EfficiencyJunky/LEDLightSticks/README.md

# LEDLightSticks
A standalone light fixture that you can also wear
