EfficiencyJunky/LEDLightSticks/ENCLOSURE/3D_MODELS/V1p2/V1p2--STEP2--BottomMain.3mf

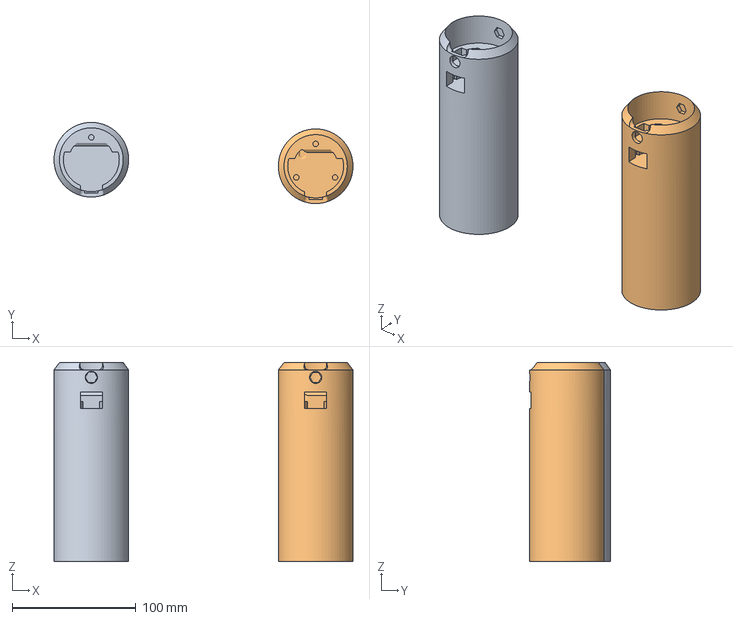
[picture p1: CAD file, 2021-01-06]
ENCLOSURE/3D_MODELS/V1p2/V1p2--STEP2--BottomMain.3mf
241.9 x 65.7 x 161.0 mm
V1--BOTTOM--sheeth_main--no_supports.stl
V1p2--BOTTOM--sheeth_main.stl
