EfficiencyJunky/LEDLightSticks/ENCLOSURE/3D_MODELS/V2p2/Lights_10_32/V1p2--STEP2--BottomMain_Updated_FAST.3mf

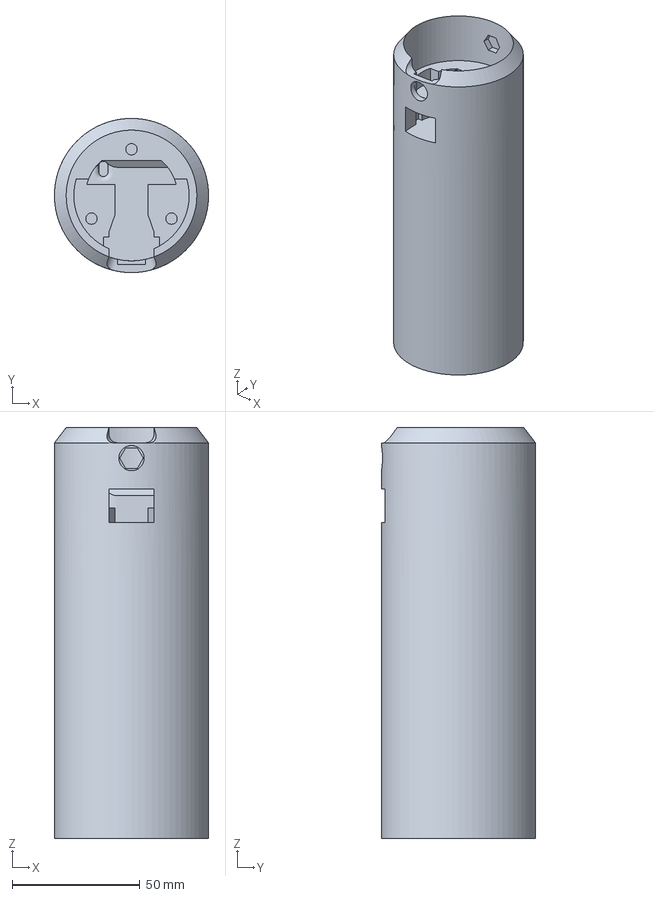
[picture p2: CAD file, 2021-01-07]
ENCLOSURE/3D_MODELS/V2p2/Lights_10_32/V1p2--STEP2--BottomMain_Updated_FAST.3mf
60.4 x 60.4 x 161.0 mm
