EfficiencyJunky/LEDLightSticks/ENCLOSURE/3D_MODELS/V2p2/Lights_M4/STEP4-TopCover/V2p2--M4--TopCover_COMPLETE_133.stl

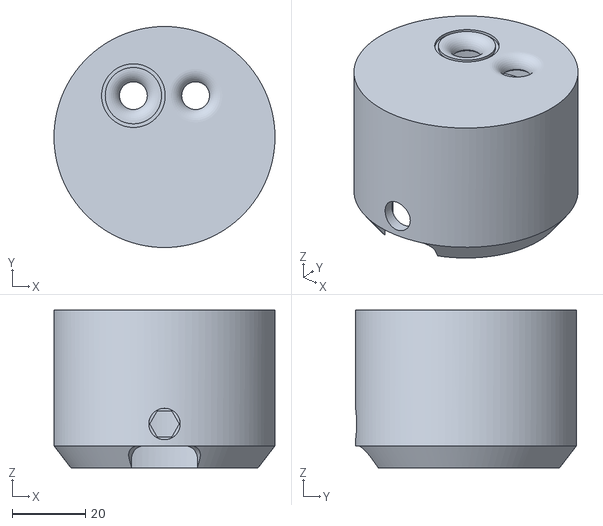
[picture p3: CAD file, 2024-03-03]
ENCLOSURE/3D_MODELS/V2p2/Lights_M4/STEP4-TopCover/V2p2--M4--TopCover_COMPLETE_133.stl
60.4 x 60.4 x 43.1
