EfficiencyJunky/LEDLightSticks/ENCLOSURE/3D_MODELS/V2p2/Lights_M4/STEP5-EntireThing/V2p2_127--M4--AllMainComponents.3mf

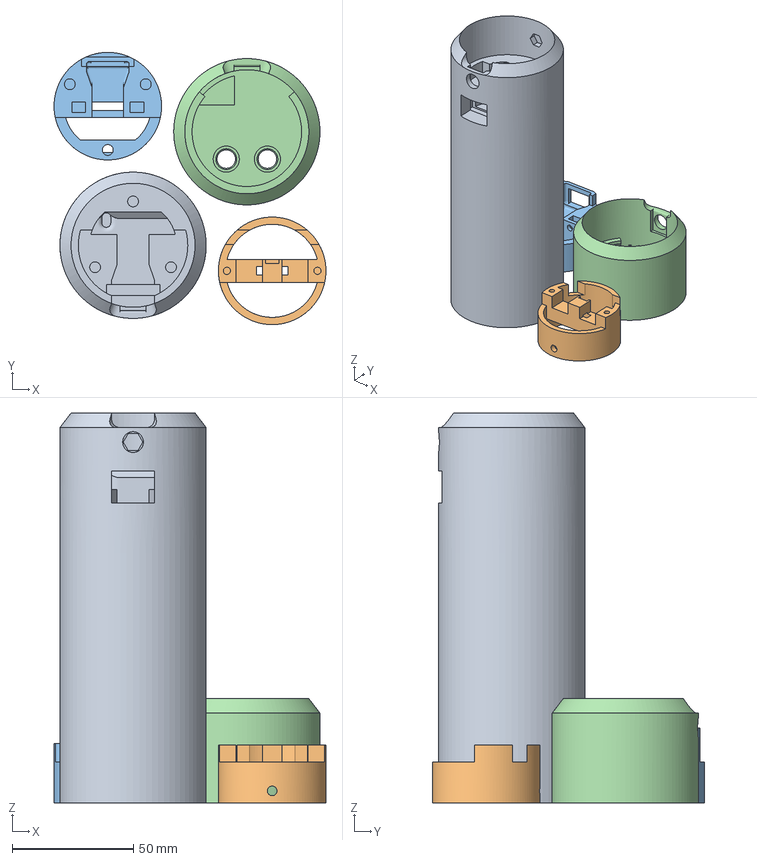
[picture p4: CAD file, 2021-03-30]
ENCLOSURE/3D_MODELS/V2p2/Lights_M4/STEP5-EntireThing/V2p2_127--M4--AllMainComponents.3mf
112.3 x 112.4 x 161.0 mm
V2p2--M4--handle_127.stl
V2p2--M4--Insert_top_123.stl
V2p2--M4--Insert_bottom_123
V2p2--M4--TopCover_COMPLETE_126.stl
