EfficiencyJunky/LEDLightSticks/ENCLOSURE/3D_MODELS/V2p2/Lights_M4/STEP4-TopCover/V2p2_133--M4--TopCover_COMPLETE_FAST_PETG.3mf

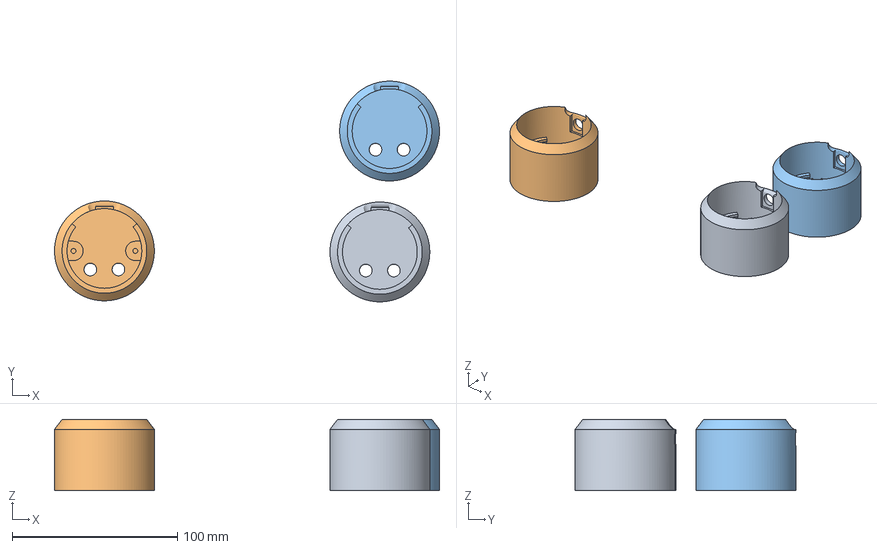
[picture p6: CAD file, 2024-03-03]
ENCLOSURE/3D_MODELS/V2p2/Lights_M4/STEP4-TopCover/V2p2_133--M4--TopCover_COMPLETE_FAST_PETG.3mf
232.9 x 133.5 x 43.1 mm
V2p2--M4--top_cover_125.stl
V2p2--M4--TopCover_COMPLETE_126.stl x 2
