EfficiencyJunky/LEDLightSticks/ENCLOSURE/3D_MODELS/V2p2/Lights_M4/STEP4-TopCover/V2p2_126--M4--TopCover_COMPLETE_FAST.3mf

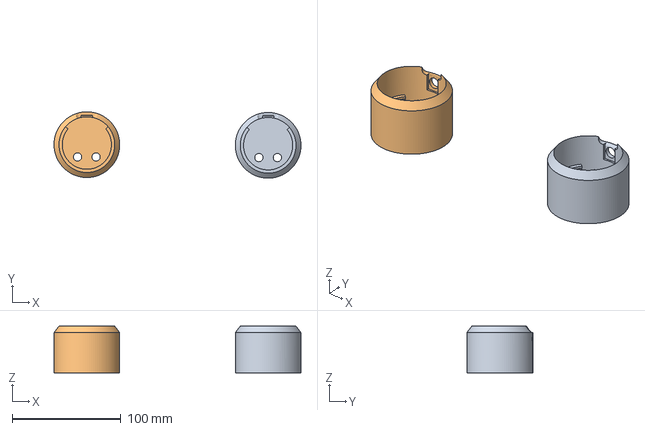
[picture p7: CAD file, 2021-03-30]
ENCLOSURE/3D_MODELS/V2p2/Lights_M4/STEP4-TopCover/V2p2_126--M4--TopCover_COMPLETE_FAST.3mf
227.0 x 61.0 x 43.1 mm
V2p2--M4--top_cover_125.stl
V2p2--M4--TopCover_COMPLETE_126.stl
