EfficiencyJunky/LEDLightSticks/ENCLOSURE/3D_MODELS/V1/V1_STLs/V1--BASE--main.stl

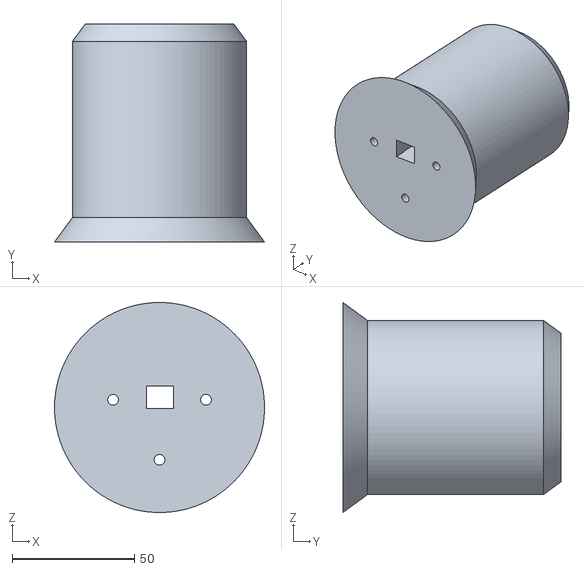
[picture p8: CAD file, 2020-12-22]
ENCLOSURE/3D_MODELS/V1/V1_STLs/V1--BASE--main.stl
85.8 x 89.1 x 85.9
