EfficiencyJunky/LEDLightSticks/ENCLOSURE/3D_MODELS/V1/V1_STLs/V1--TOP--sheeth_cap.stl

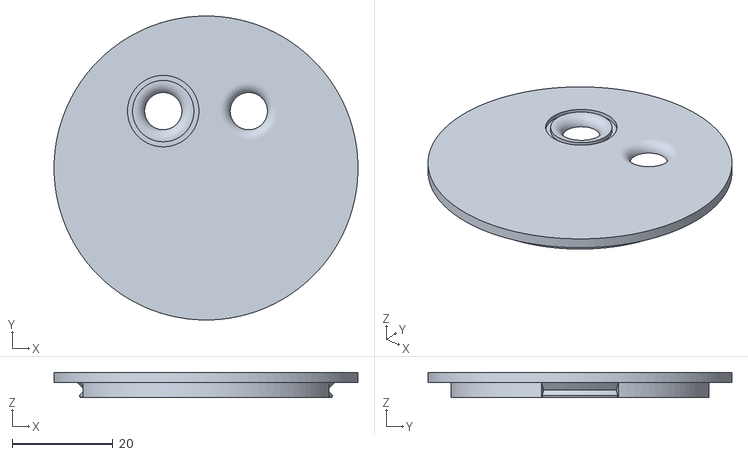
[picture p10: CAD file, 2020-12-22]
ENCLOSURE/3D_MODELS/V1/V1_STLs/V1--TOP--sheeth_cap.stl
60.4 x 60.4 x 5.00
