EfficiencyJunky/LEDLightSticks/ENCLOSURE/3D_MODELS/V2p2/Base/STEP1-PowerShimStorage/V2p2--power_shim_storage_006.stl

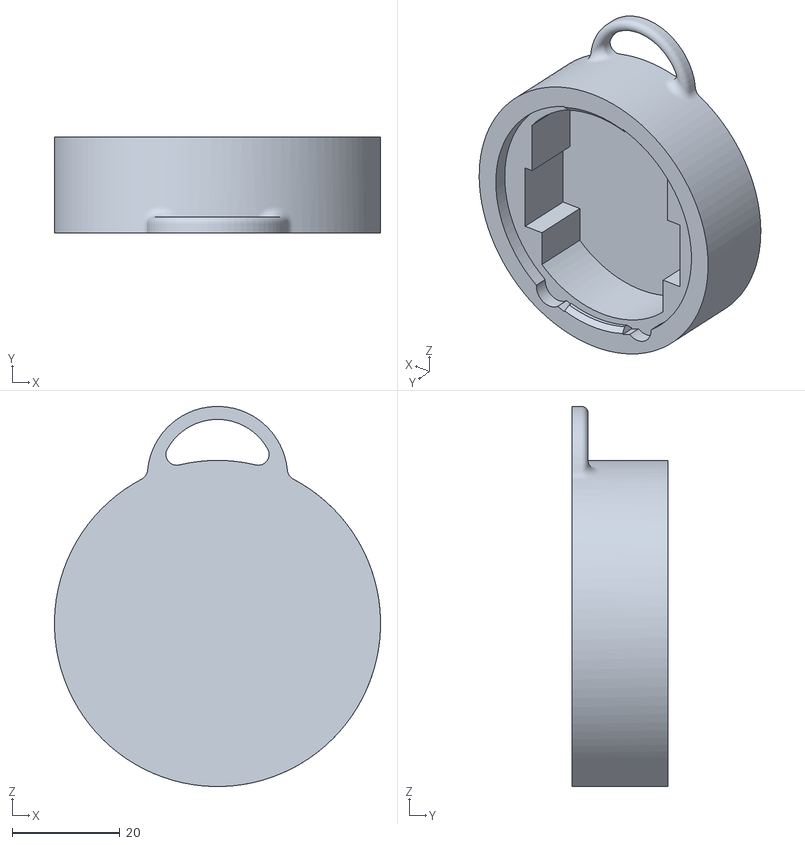
[picture p11: CAD file, 2021-02-16]
ENCLOSURE/3D_MODELS/V2p2/Base/STEP1-PowerShimStorage/V2p2--power_shim_storage_006.stl
60.4 x 17.8 x 70.4
