EfficiencyJunky/LEDLightSticks/ENCLOSURE/3D_MODELS/V2p2/Base/STEP4-PCBCover/V2p2_047--pcb_cover.3mf

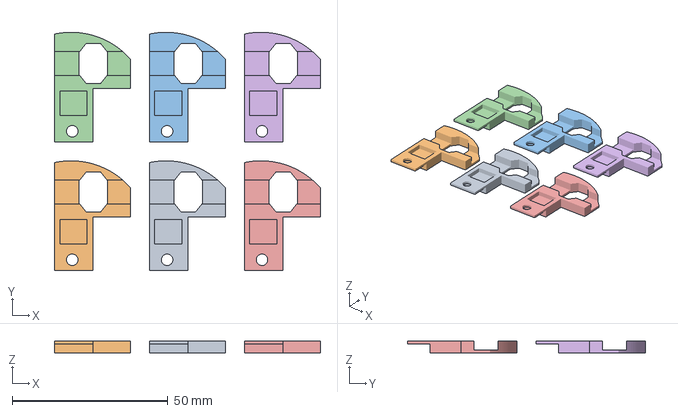
[picture p12: CAD file, 2021-03-30]
ENCLOSURE/3D_MODELS/V2p2/Base/STEP4-PCBCover/V2p2_047--pcb_cover.3mf
85.5 x 76.6 x 4.00 mm
V2p2--pcb_cover_047.stl x 6
