EfficiencyJunky/LEDLightSticks/ENCLOSURE/3D_MODELS/V2p2/Lights_M4/_OTHER_3D_FILES/STEP_BottomCoverCap_for_jake.step

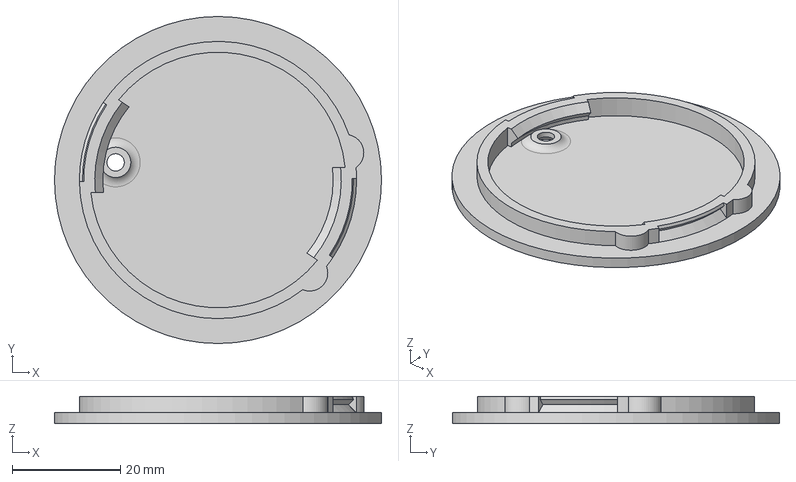
[picture p13: CAD file, 2024-03-03]
ENCLOSURE/3D_MODELS/V2p2/Lights_M4/_OTHER_3D_FILES/STEP_BottomCoverCap_for_jake.step
60.4 x 60.4 x 5.00 mm
