EfficiencyJunky/LEDLightSticks/ENCLOSURE/3D_MODELS/V2p2/Lights_M4/STEP0-Jig/V2p2--Jig_123.stl

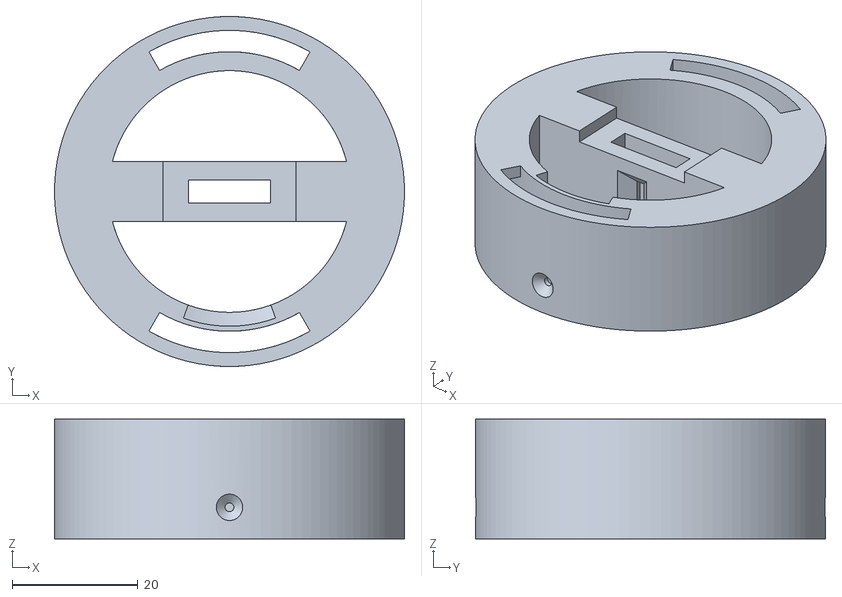
[picture p14: CAD file, 2021-02-16]
ENCLOSURE/3D_MODELS/V2p2/Lights_M4/STEP0-Jig/V2p2--Jig_123.stl
55.6 x 55.6 x 19.0
