EfficiencyJunky/LEDLightSticks/ENCLOSURE/3D_MODELS/V2p2/Lights_M4/STEP1-Inserts/V2p2--M4--Insert_bottom_133.stl

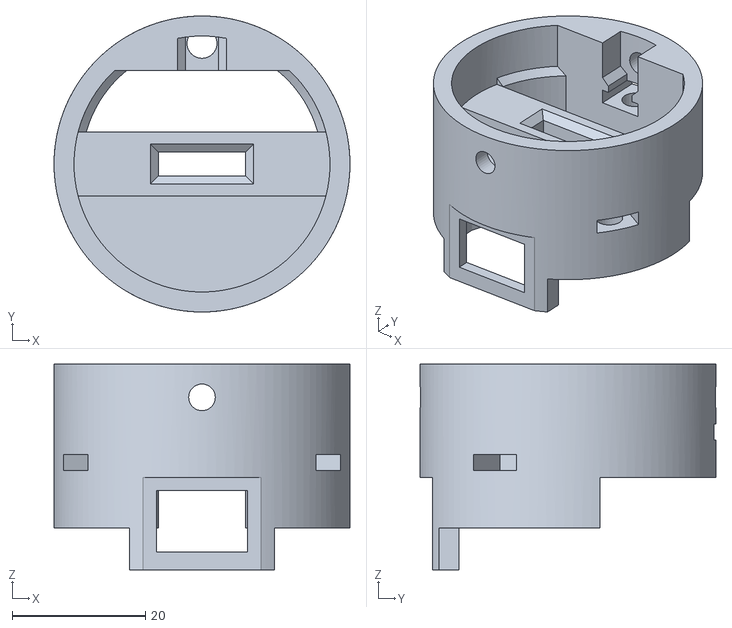
[picture p15: CAD file, 2024-03-03]
ENCLOSURE/3D_MODELS/V2p2/Lights_M4/STEP1-Inserts/V2p2--M4--Insert_bottom_133.stl
44.4 x 44.4 x 30.9
