EfficiencyJunky/LEDLightSticks/ENCLOSURE/3D_MODELS/V2p2/Lights_M4/STEP2-Handle/V2p2_127--M4--Handle_FAST.3mf

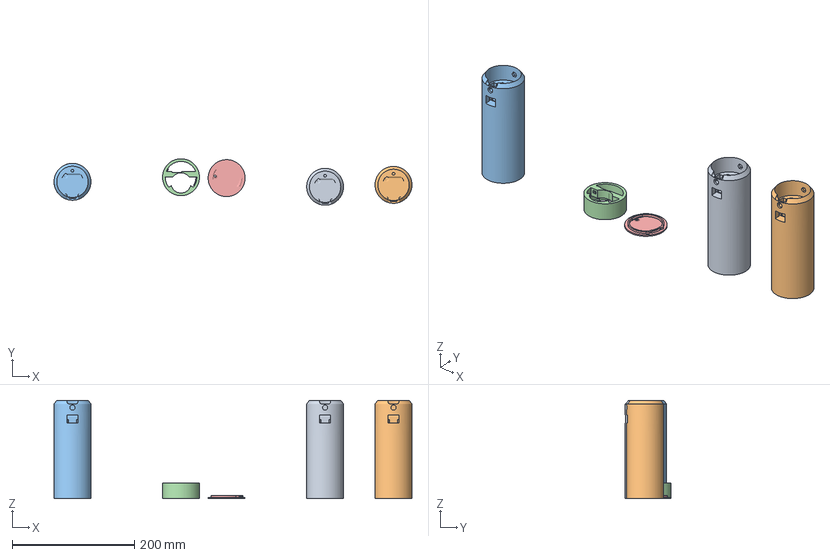
[picture p16: CAD file, 2024-03-03]
ENCLOSURE/3D_MODELS/V2p2/Lights_M4/STEP2-Handle/V2p2_127--M4--Handle_FAST.3mf
585.4 x 76.0 x 161.0 mm
V2p2--M4--handle_123.stl
V2p2--M4--handle_127.stl
V2p2--M4--handle_133.stl
V2p2--M4--handle_133_partial.stl
V2p2--bottom_cap_133.stl
