EfficiencyJunky/LEDLightSticks/ENCLOSURE/3D_MODELS/V1/V1--TOP.3mf

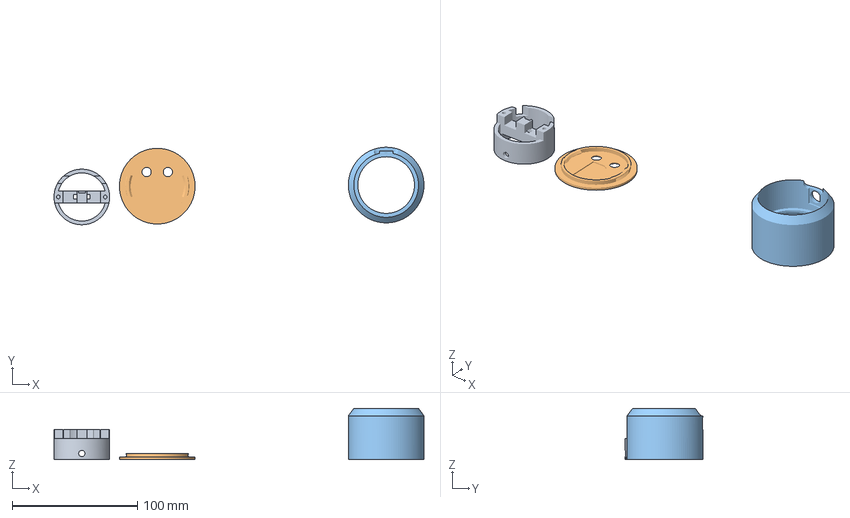
[picture p19: CAD file, 2020-12-22]
ENCLOSURE/3D_MODELS/V1/V1--TOP.3mf
295.4 x 61.9 x 41.1 mm
V1--TOP--foundation_insert.stl
V1--TOP--sheeth_cap.stl
V1--TOP--sheeth_main.stl
