EfficiencyJunky/LEDLightSticks/ENCLOSURE/3D_MODELS/V1/V1_STLs/V1--BOTTOM--battery_securing_clip.stl

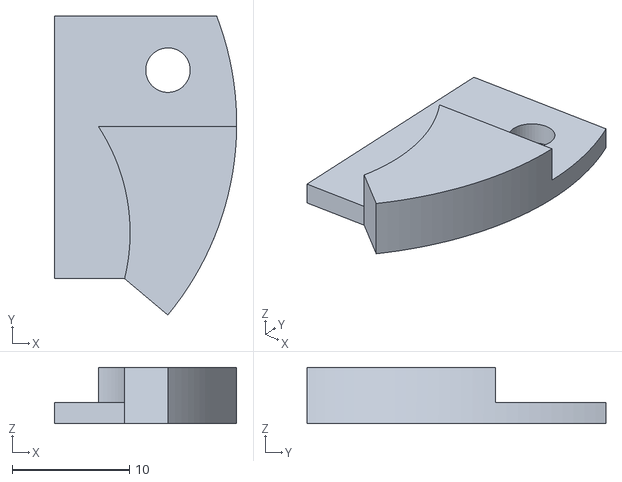
[picture p20: CAD file, 2020-12-22]
ENCLOSURE/3D_MODELS/V1/V1_STLs/V1--BOTTOM--battery_securing_clip.stl
15.6 x 25.5 x 4.80
