EfficiencyJunky/LEDLightSticks/ENCLOSURE/3D_MODELS/V2p2/Base/STEP4-PCBCover/V2p2--pcb_cover_047.stl

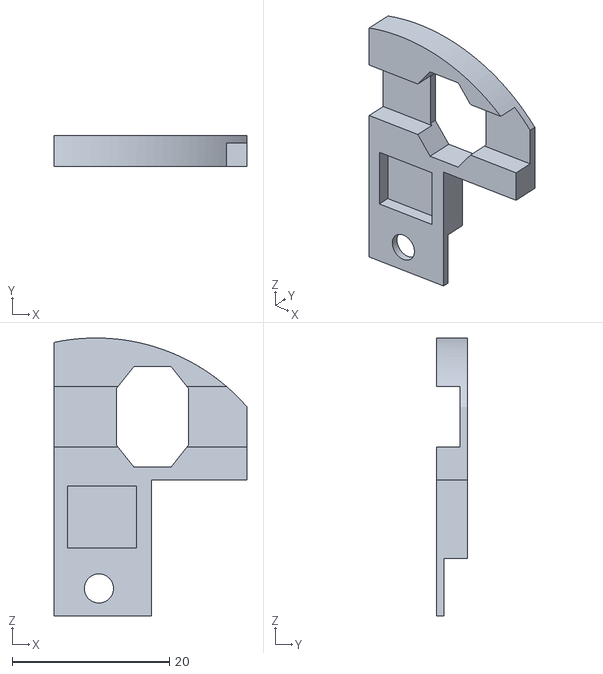
[picture p21: CAD file, 2021-02-16]
ENCLOSURE/3D_MODELS/V2p2/Base/STEP4-PCBCover/V2p2--pcb_cover_047.stl
24.5 x 4.00 x 35.3
