EfficiencyJunky/LEDLightSticks/ENCLOSURE/3D_MODELS/V2p2/Lights_M4/STEP1-Inserts/V2p2--M4--Inserts--133.3mf

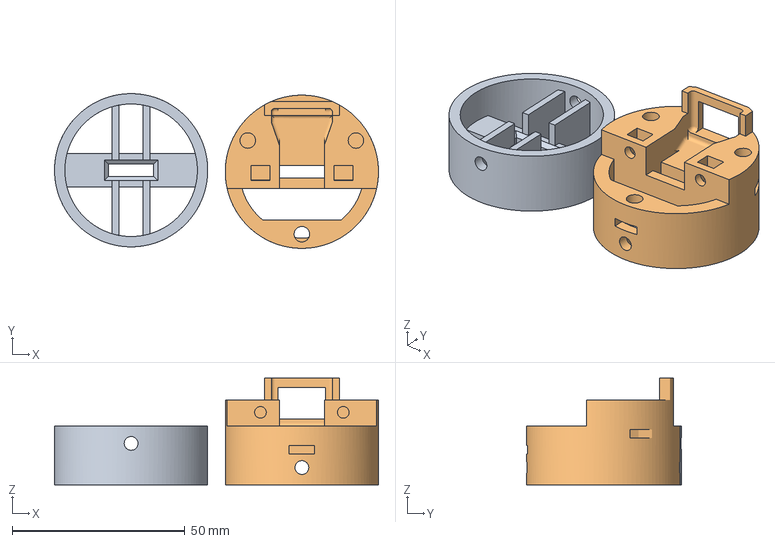
[picture p22: CAD file, 2024-03-03]
ENCLOSURE/3D_MODELS/V2p2/Lights_M4/STEP1-Inserts/V2p2--M4--Inserts--133.3mf
93.9 x 44.8 x 30.9 mm
V2p2--M4--Insert_top_123.stl
V2p2--M4--Insert_bottom_123
