EfficiencyJunky/LEDLightSticks/ENCLOSURE/3D_MODELS/V2p2/Lights_M4/STEP2-Handle/V2p2_135--M4--Handle_20um_layer_height_PETG.3mf

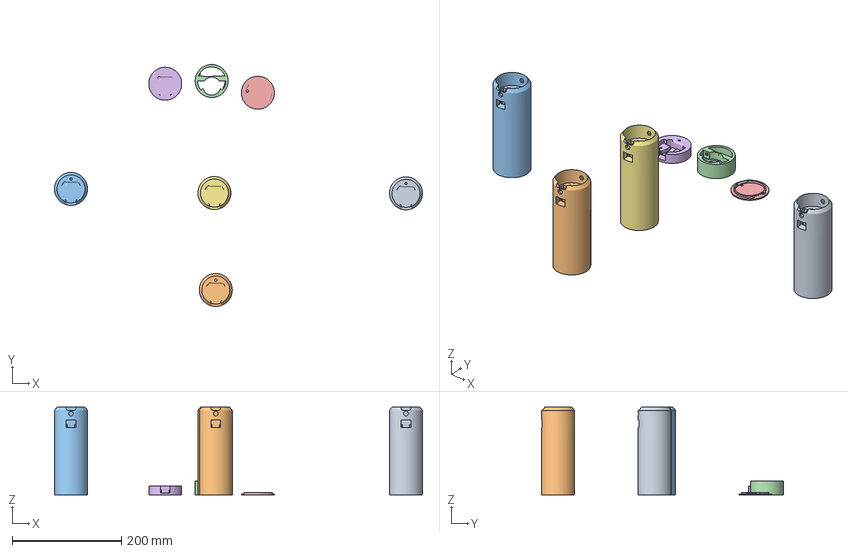
[picture p23: CAD file, 2024-03-03]
ENCLOSURE/3D_MODELS/V2p2/Lights_M4/STEP2-Handle/V2p2_135--M4--Handle_20um_layer_height_PETG.3mf
673.5 x 442.9 x 161.0 mm
V2p2--M4--handle_123.stl
V2p2--M4--handle_127.stl
V2p2--M4--handle_133.stl
V2p2--M4--handle_133_partial.stl
V2p2--bottom_cap_133.stl
V2p2--M4--handle_135_screw_fitting_area.stl
V2p2--M4--handle_135.stl
