EfficiencyJunky/LEDLightSticks/ENCLOSURE/3D_MODELS/V2p2/Lights_M4/STEP3-SmallComponents/V2p2_123--5x_Small_Components.3mf

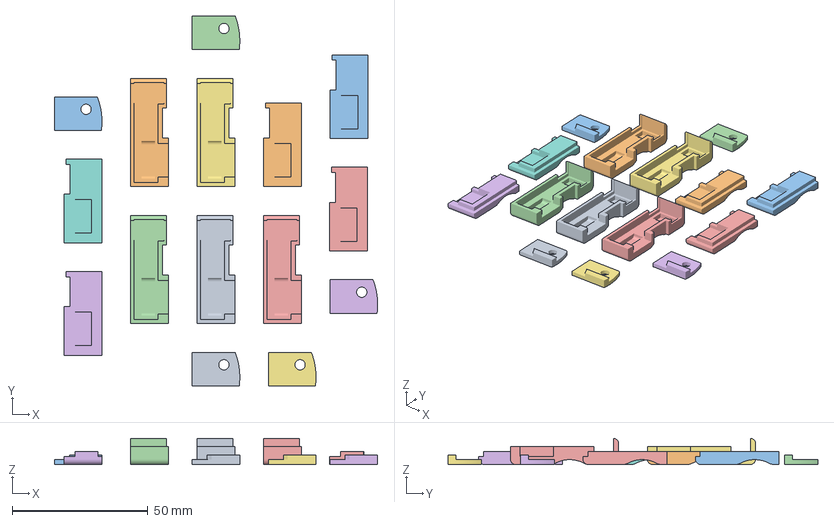
[picture p24: CAD file, 2024-03-03]
ENCLOSURE/3D_MODELS/V2p2/Lights_M4/STEP3-SmallComponents/V2p2_123--5x_Small_Components.3mf
119.3 x 136.5 x 9.60 mm
V2p2--powerShimCase_bottom_123.stl x 5
V2p2--powerShimCase_top_123.stl x 5
V2p2--battery_clip_123.stl x 5
