EfficiencyJunky/LEDLightSticks/ENCLOSURE/3D_MODELS/V1/V1--BOTTOM.3mf

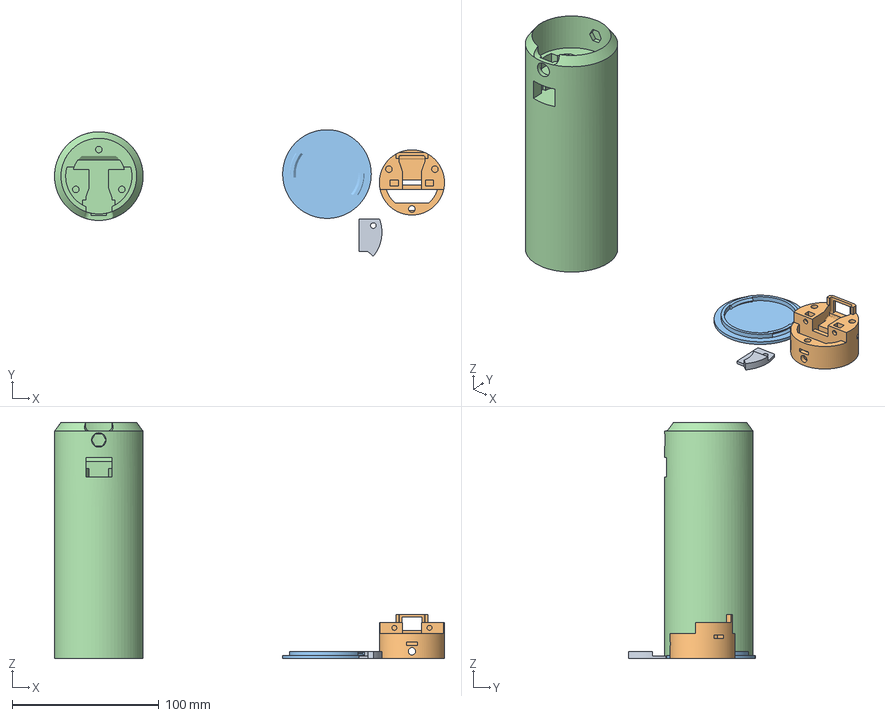
[picture p25: CAD file, 2020-12-22]
ENCLOSURE/3D_MODELS/V1/V1--BOTTOM.3mf
265.8 x 86.2 x 161.0 mm
V1--BOTTOM--battery_securing_clip.stl
V1--BOTTOM--foundation_insert.stl
V1--BOTTOM--sheeth_cap.stl
V1--BOTTOM--sheeth_main--no_supports.stl
