EfficiencyJunky/LEDLightSticks/ENCLOSURE/3D_MODELS/V2p2/Lights_M4/STEP1-Inserts/V2p2--M4--Insert_top_133.stl

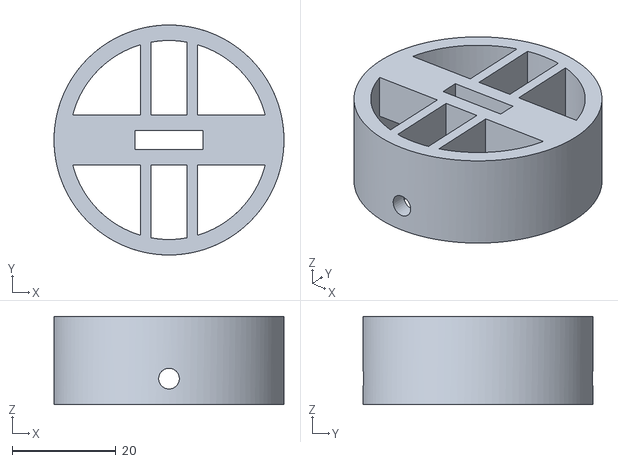
[picture p27: CAD file, 2024-03-03]
ENCLOSURE/3D_MODELS/V2p2/Lights_M4/STEP1-Inserts/V2p2--M4--Insert_top_133.stl
44.4 x 44.4 x 17.0
