EfficiencyJunky/LEDLightSticks/ENCLOSURE/3D_MODELS/V2p2/Lights_10_32/V1p2--STEP1--TopAndBottomInserts.3mf

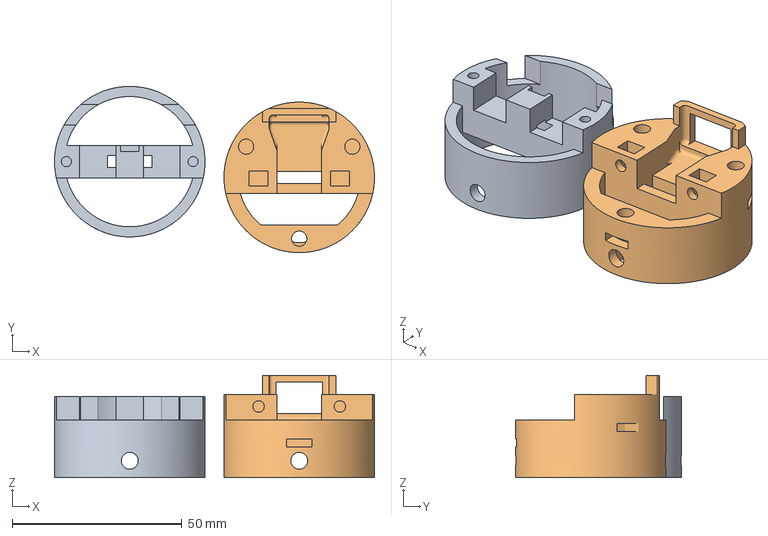
[picture p28: CAD file, 2021-01-05]
ENCLOSURE/3D_MODELS/V2p2/Lights_10_32/V1p2--STEP1--TopAndBottomInserts.3mf
94.4 x 49.0 x 30.2 mm
V1--TOP--foundation_insert.stl
V1--BOTTOM--foundation_insert.stl
