EfficiencyJunky/LEDLightSticks/ENCLOSURE/3D_MODELS/V2p2/Lights_M4/STEP1-Inserts/V2p2_133--M4--4X_Inserts_top_bottom_PLA.3mf

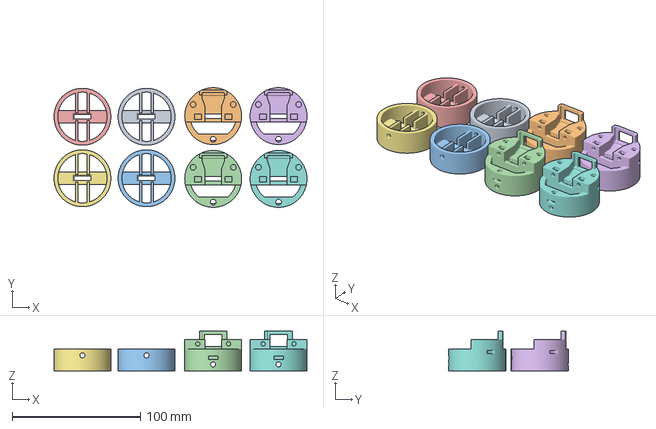
[picture p29: CAD file, 2024-03-03]
ENCLOSURE/3D_MODELS/V2p2/Lights_M4/STEP1-Inserts/V2p2_133--M4--4X_Inserts_top_bottom_PLA.3mf
197.4 x 93.4 x 30.9 mm
V2p2--M4--Insert_top_123.stl x 4
V2p2--M4--Insert_bottom_123 x 4
