EfficiencyJunky/LEDLightSticks/ENCLOSURE/3D_MODELS/V2p2/Lights_M4/STEP3-SmallComponents/V2p2_133--5x_Bottom_Cap_PLA.3mf

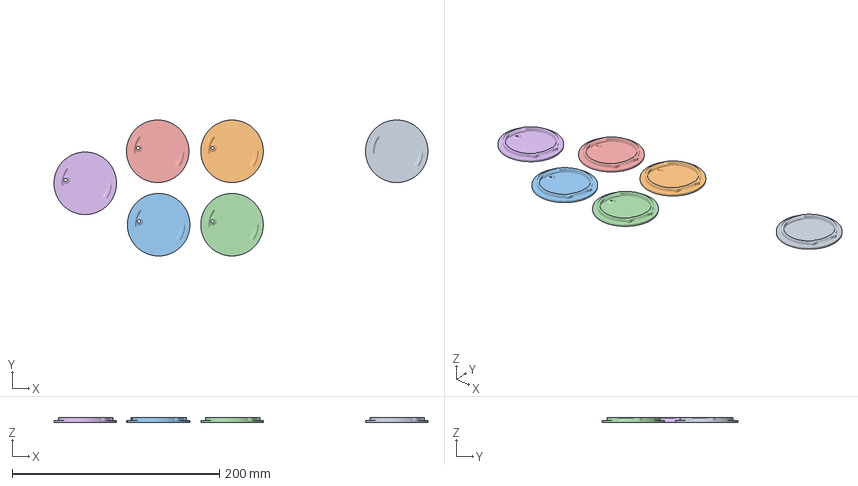
[picture p30: CAD file, 2024-03-03]
ENCLOSURE/3D_MODELS/V2p2/Lights_M4/STEP3-SmallComponents/V2p2_133--5x_Bottom_Cap_PLA.3mf
361.3 x 131.3 x 5.00 mm
V2p2--bottom_cap_125.stl
V2p2--bottom_cap_133.stl x 5
