EfficiencyJunky/LEDLightSticks/ENCLOSURE/3D_MODELS/V1/V1_STLs/V1--BOTTOM--foundation_insert.stl

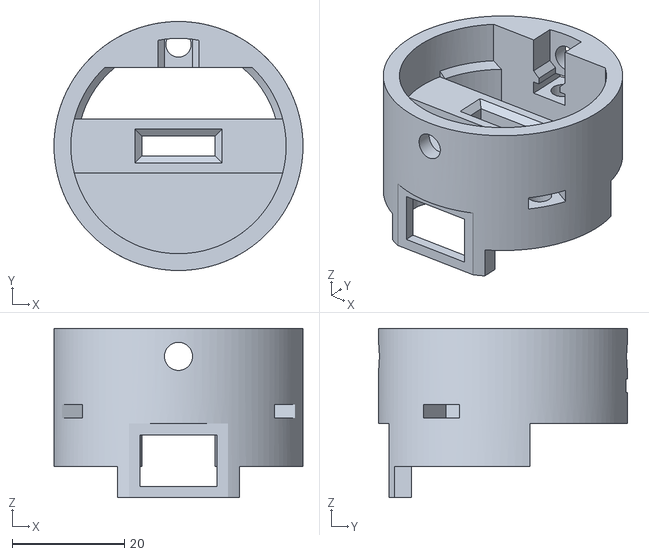
[picture p31: CAD file, 2020-12-22]
ENCLOSURE/3D_MODELS/V1/V1_STLs/V1--BOTTOM--foundation_insert.stl
44.4 x 44.4 x 30.2
