EfficiencyJunky/LEDLightSticks/ENCLOSURE/3D_MODELS/V2p2/Lights_10_32/V1p2--STEP4--TopSheethAndCap.3mf

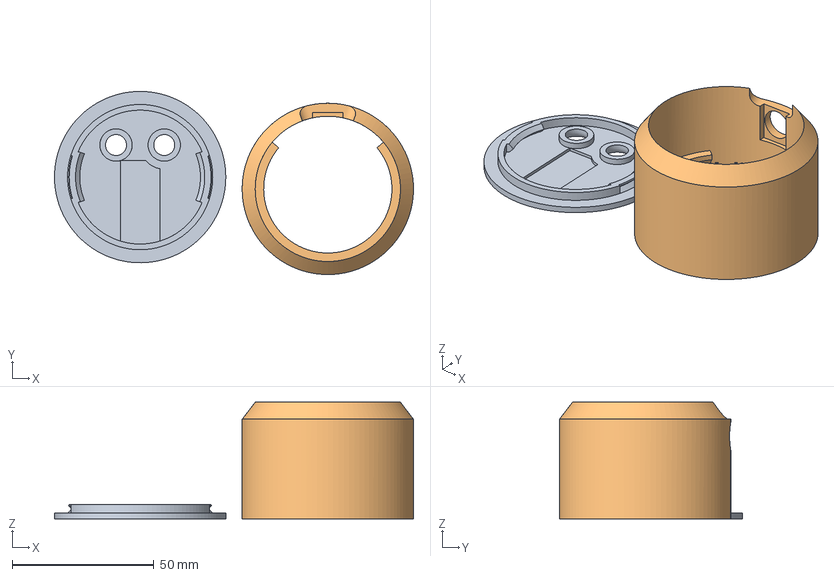
[picture p32: CAD file, 2021-01-05]
ENCLOSURE/3D_MODELS/V2p2/Lights_10_32/V1p2--STEP4--TopSheethAndCap.3mf
126.5 x 64.6 x 41.1 mm
V1p2--TOP--sheeth_cap.stl
V1p2--TOP--sheeth_main.stl
