EfficiencyJunky/LEDLightSticks/ENCLOSURE/3D_MODELS/V2p2/Lights_M4/STEP3-SmallComponents/V2p2_133--4x_Bottom_Cap_PETG.3mf

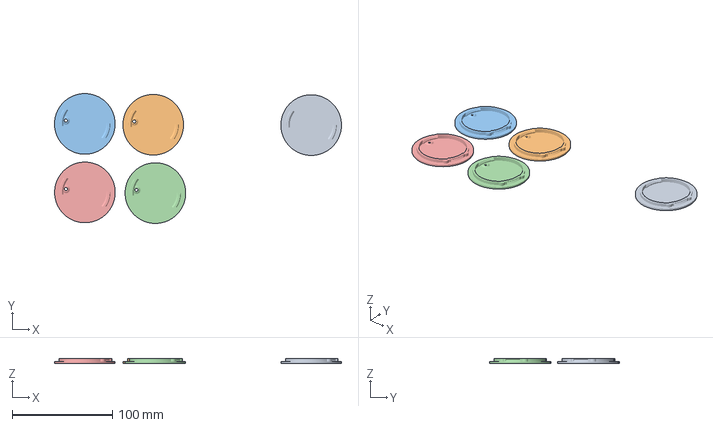
[picture p33: CAD file, 2024-03-03]
ENCLOSURE/3D_MODELS/V2p2/Lights_M4/STEP3-SmallComponents/V2p2_133--4x_Bottom_Cap_PETG.3mf
286.0 x 129.4 x 5.00 mm
V2p2--bottom_cap_125.stl
V2p2--bottom_cap_133.stl x 4
