EfficiencyJunky/LEDLightSticks/ENCLOSURE/3D_MODELS/V2p2/Lights_M4/STEP3-SmallComponents/V2p2_123--Small_Components.3mf

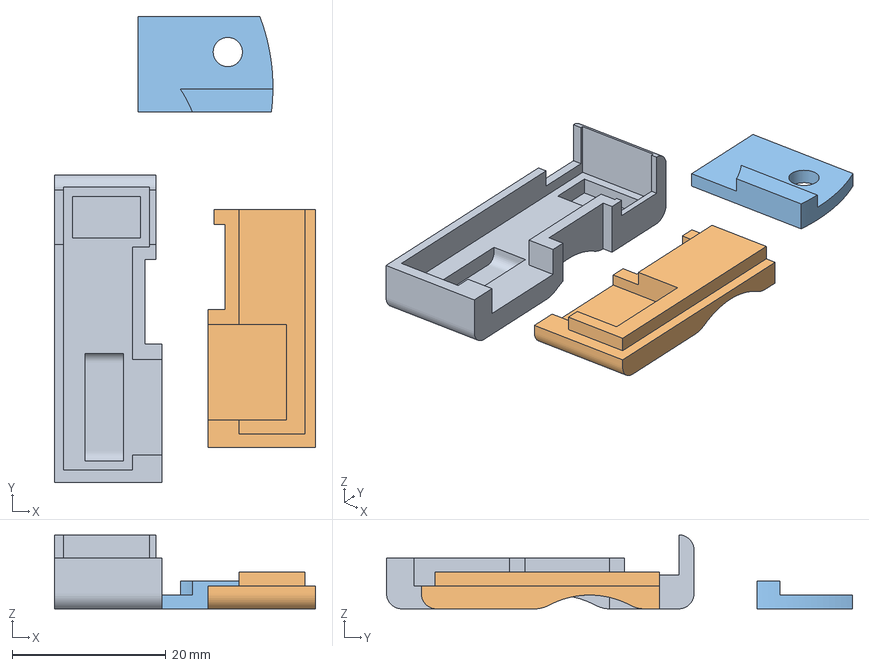
[picture p34: CAD file, 2024-03-03]
ENCLOSURE/3D_MODELS/V2p2/Lights_M4/STEP3-SmallComponents/V2p2_123--Small_Components.3mf
34.0 x 60.6 x 9.60 mm
V2p2--powerShimCase_bottom_123.stl
V2p2--powerShimCase_top_123.stl
V2p2--battery_clip_123.stl
