EfficiencyJunky/LEDLightSticks/ENCLOSURE/3D_MODELS/V2p2/Lights_M4/STEP3-SmallComponents/V2p2--powerShimCase_bottom_123.stl

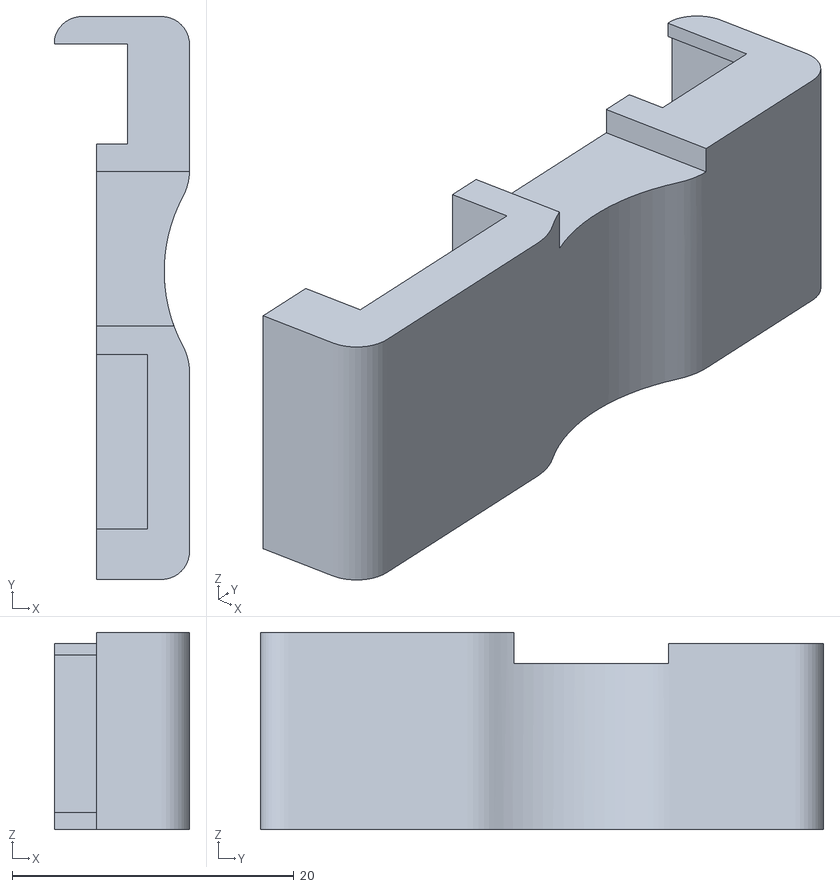
[picture p35: CAD file, 2021-02-16]
ENCLOSURE/3D_MODELS/V2p2/Lights_M4/STEP3-SmallComponents/V2p2--powerShimCase_bottom_123.stl
9.60 x 40.0 x 14.0
