EfficiencyJunky/LEDLightSticks/ENCLOSURE/3D_MODELS/V2p2/Lights_M4/STEP3-SmallComponents/V2p2--battery_clip_123.stl

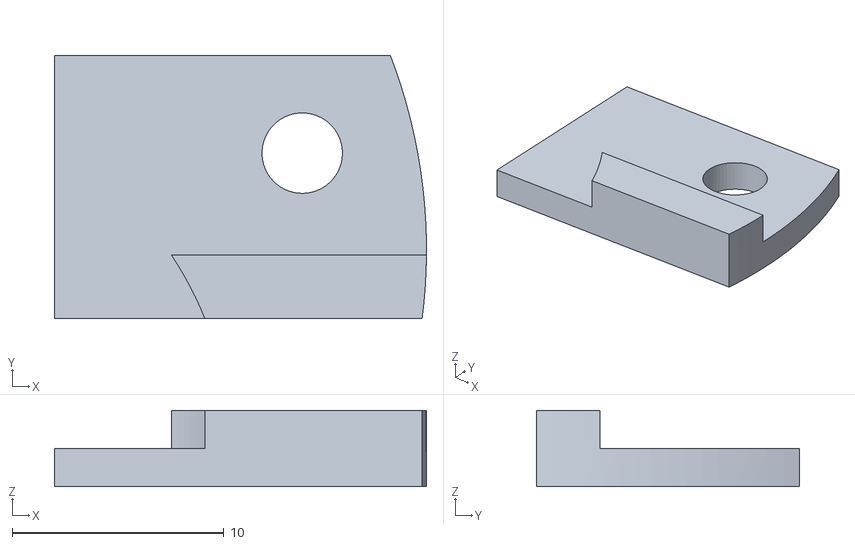
[picture p36: CAD file, 2021-02-16]
ENCLOSURE/3D_MODELS/V2p2/Lights_M4/STEP3-SmallComponents/V2p2--battery_clip_123.stl
17.6 x 12.4 x 3.60
