EfficiencyJunky/LEDLightSticks/ENCLOSURE/3D_MODELS/V2p2/Lights_M4/STEP3-SmallComponents/V2p2--powerShimCase_top_123.stl

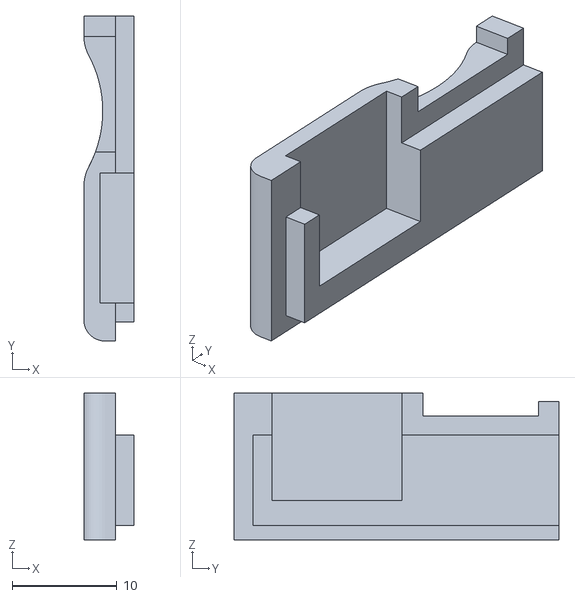
[picture p37: CAD file, 2021-02-16]
ENCLOSURE/3D_MODELS/V2p2/Lights_M4/STEP3-SmallComponents/V2p2--powerShimCase_top_123.stl
4.80 x 31.0 x 14.0
