EfficiencyJunky/LEDLightSticks/(list of files, cad)

Other CAD files:
ENCLOSURE/3D_MODELS/V2p2/Lights_10_32/V1p2--STEP2--BottomMain_Updated.3mf
ENCLOSURE/3D_MODELS/V2p2/Lights_M4/STEP4-TopCover/V2p2_133--M4--TopCover_COMPLETE_FAST.3mf
ENCLOSURE/3D_MODELS/V2p2/Lights_M4/STEP4-TopCover/V2p2--M4--TopCover_COMPLETE_126.stl
ENCLOSURE/3D_MODELS/V1/V1_STLs/V1--BOTTOM--sheeth_main--no_supports.stl
ENCLOSURE/3D_MODELS/V1/V1_STLs/V1--BOTTOM--sheeth_main--supports.stl
ENCLOSURE/3D_MODELS/V1/V1--BASE.3mf
ENCLOSURE/3D_MODELS/V2p2/Base/STEP3-BaseMain/V2p2_058--Base.3mf
ENCLOSURE/3D_MODELS/V2p2/Base/STEP1-PowerShimStorage/V2p2_006--power_shim_storage.3mf
ENCLOSURE/3D_MODELS/V2p2/Base/STEP3-BaseMain/V2p2_057--Base.3mf
ENCLOSURE/3D_MODELS/V2p2/Lights_M4/STEP0-Jig/V2p2_123--Jig.3mf
ENCLOSURE/3D_MODELS/V2p2/Lights_10_32/V1p2--JIGS.3mf
ENCLOSURE/3D_MODELS/V2p2/Lights_M4/STEP2-Handle/V2p2--M4--handle_135.stl
ENCLOSURE/3D_MODELS/V2p2/Lights_M4/STEP3-SmallComponents/V2p2_133--Bottom_Cap_PLA.3mf
ENCLOSURE/3D_MODELS/V1/V1_STLs/V1--BOTTOM--sheeth_cap.stl
ENCLOSURE/3D_MODELS/V2p2/Lights_M4/STEP2-Handle/V2p2_135--M4--Handle_FAST.3mf
ENCLOSURE/3D_MODELS/V2p2/Lights_M4/STEP1-Inserts/V2p2--M4--Insert_top_123.stl
ENCLOSURE/3D_MODELS/V2p2/Lights_M4/STEP2-Handle/V2p2_135--M4--Handle_FAST_PETG.3mf
ENCLOSURE/3D_MODELS/V2p2/Lights_M4/STEP1-Inserts/V2p2--M4--Insert_bottom_123.stl
ENCLOSURE/3D_MODELS/V2p2/Lights_M4/STEP2-Handle/V2p2--M4--handle_133.stl
ENCLOSURE/3D_MODELS/V2p2/Lights_M4/STEP3-SmallComponents/V2p2--bottom_cap_133.stl
ENCLOSURE/3D_MODELS/V2p2/Lights_M4/STEP4-TopCover/V2p2_123--M4--TopCover.3mf
ENCLOSURE/3D_MODELS/V2p2/Lights_M4/STEP1-Inserts/V2p2--M4--Inserts-123.3mf
ENCLOSURE/3D_MODELS/V2p2/Lights_M4/STEP2-Handle/V2p2--M4--handle_123.stl
ENCLOSURE/3D_MODELS/V2p2/Lights_M4/STEP2-Handle/V2p2--M4--handle_127.stl
ENCLOSURE/3D_MODELS/V2p2/Lights_M4/STEP2-Handle/V2p2_123--M4--Handle.3mf
ENCLOSURE/3D_MODELS/V2p2/Lights_M4/STEP3-SmallComponents/V2p2--bottom_cap_125.stl
ENCLOSURE/3D_MODELS/V2p2/Lights_M4/STEP3-SmallComponents/V2p2_125--Bottom_Cap.3mf
ENCLOSURE/3D_MODELS/V2p2/Base/STEP3-BaseMain/V2p2_058--Base.stl
