EfficiencyJunky/LEDLightSticks/BUILD/Base/README.md

# LED Light Sticks 2.0 - Acrylic Base Build

## Tools
**PlastiDrill Bit**
* **5/32"** for M4 Mounting Bolt Holes in Acrylic Base
* **1/4"** for starter hole in Acrylic base where power plug goes

**Regular Drill Bits**
* **1/2"** for final hole in Acrylic base where power plug goes

# Acrylic Base Preparation
## 	PARTS
1. 1x -- Acrylic Base
2. 1x -- 3D Printed LED Light Stick Holder
3. 1x -- PCB #5
   1. Molex Male Straight Header
   2. DC Barrel Connector - Vertical Board Mount
4. 1x -- 3D Printed cover for PCB
5. 3x -- 4M x 25mm Bolts
6. 3x -- 4M Hex lock nuts
7. 3x -- #6 x 1/4" Thread Cutting Screws
8.  5x -- Rubber feet
9.  1x -- USB to Barrel connector cable (6ft)
