EfficiencyJunky/LEDLightSticks/BUILD/LightSticks/TUTORIAL_IMAGES/STEP_01/02--Mark_hole_placements.jpeg

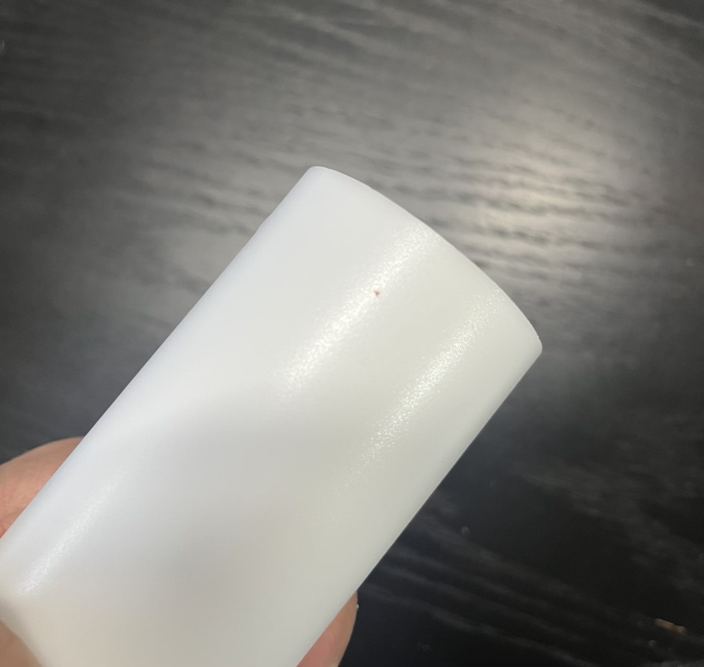
BUILD/LightSticks/TUTORIAL_IMAGES/STEP_01/02--Mark_hole_placements.jpeg
