EfficiencyJunky/LEDLightSticks/BUILD/LightSticks/TUTORIAL_IMAGES/STEP_01/03--Drill_hole.jpeg

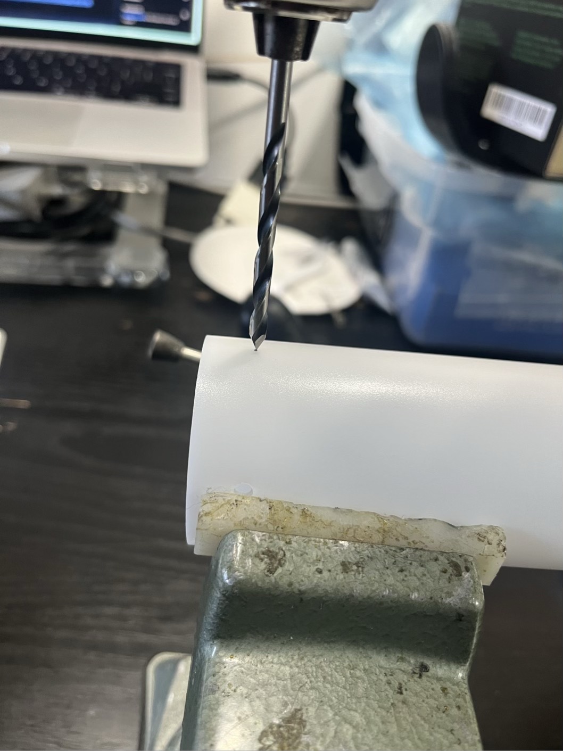
BUILD/LightSticks/TUTORIAL_IMAGES/STEP_01/03--Drill_hole.jpeg
