EfficiencyJunky/LEDLightSticks/BUILD/LightSticks/TUTORIAL_IMAGES/STEP_01/05--Mark_flat_bar.jpeg

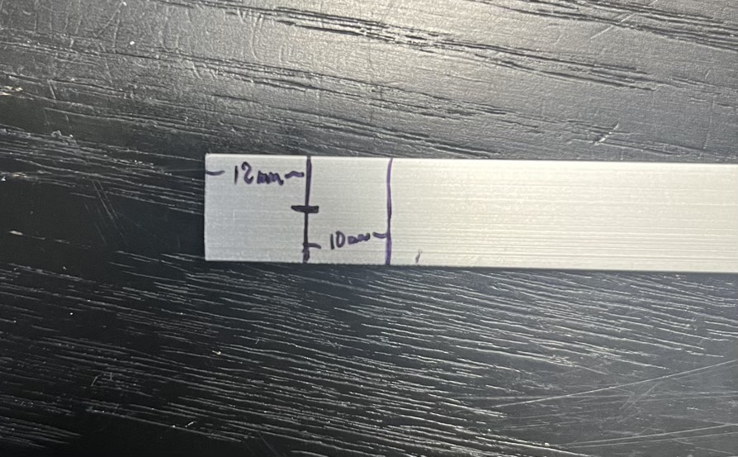
BUILD/LightSticks/TUTORIAL_IMAGES/STEP_01/05--Mark_flat_bar.jpeg
