EfficiencyJunky/LEDLightSticks/BUILD/LightSticks/TUTORIAL_IMAGES/STEP_01/06--Drill_flat_bar.jpeg

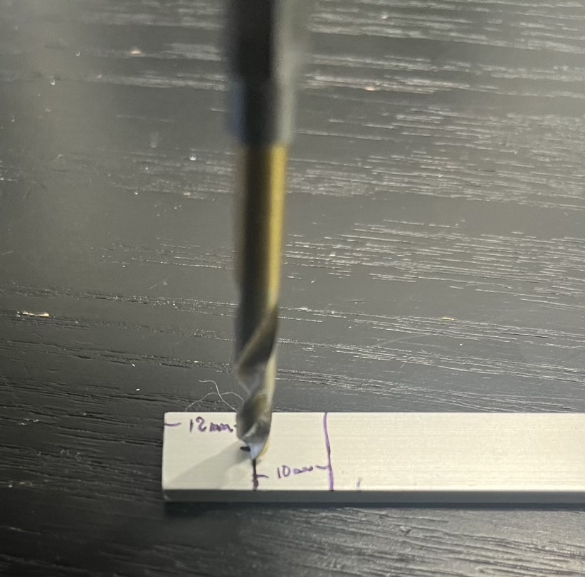
BUILD/LightSticks/TUTORIAL_IMAGES/STEP_01/06--Drill_flat_bar.jpeg
