EfficiencyJunky/LEDLightSticks/BUILD/LightSticks/TUTORIAL_IMAGES/STEP_01/08--fit_flat_bar_in_insert.jpeg

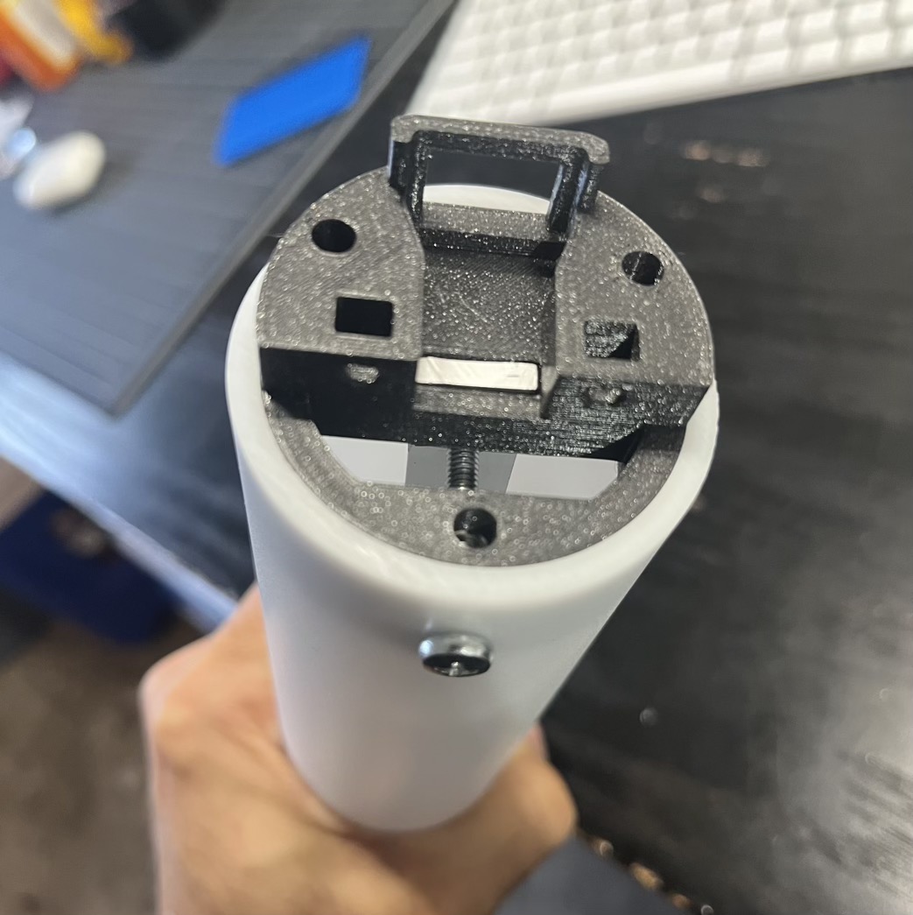
BUILD/LightSticks/TUTORIAL_IMAGES/STEP_01/08--fit_flat_bar_in_insert.jpeg
