EfficiencyJunky/LEDLightSticks/BUILD/LightSticks/TUTORIAL_IMAGES/STEP_01/09--fit_jig_on_other_end.jpeg

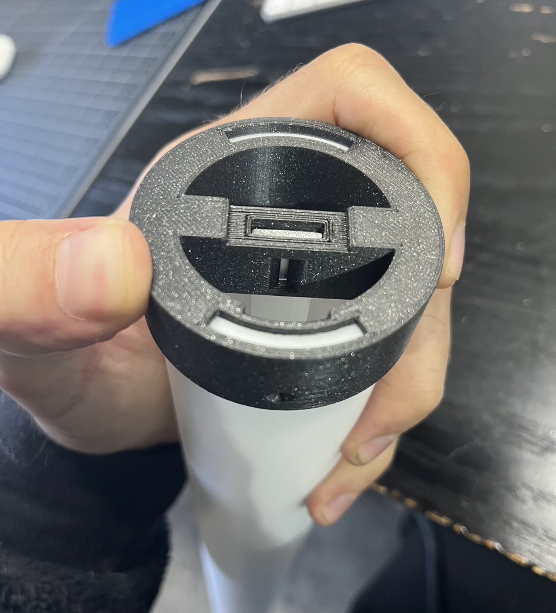
BUILD/LightSticks/TUTORIAL_IMAGES/STEP_01/09--fit_jig_on_other_end.jpeg
