EfficiencyJunky/LEDLightSticks/BUILD/LightSticks/TUTORIAL_IMAGES/STEP_01/11--Mark_actylic_tube_hole_placements.jpeg

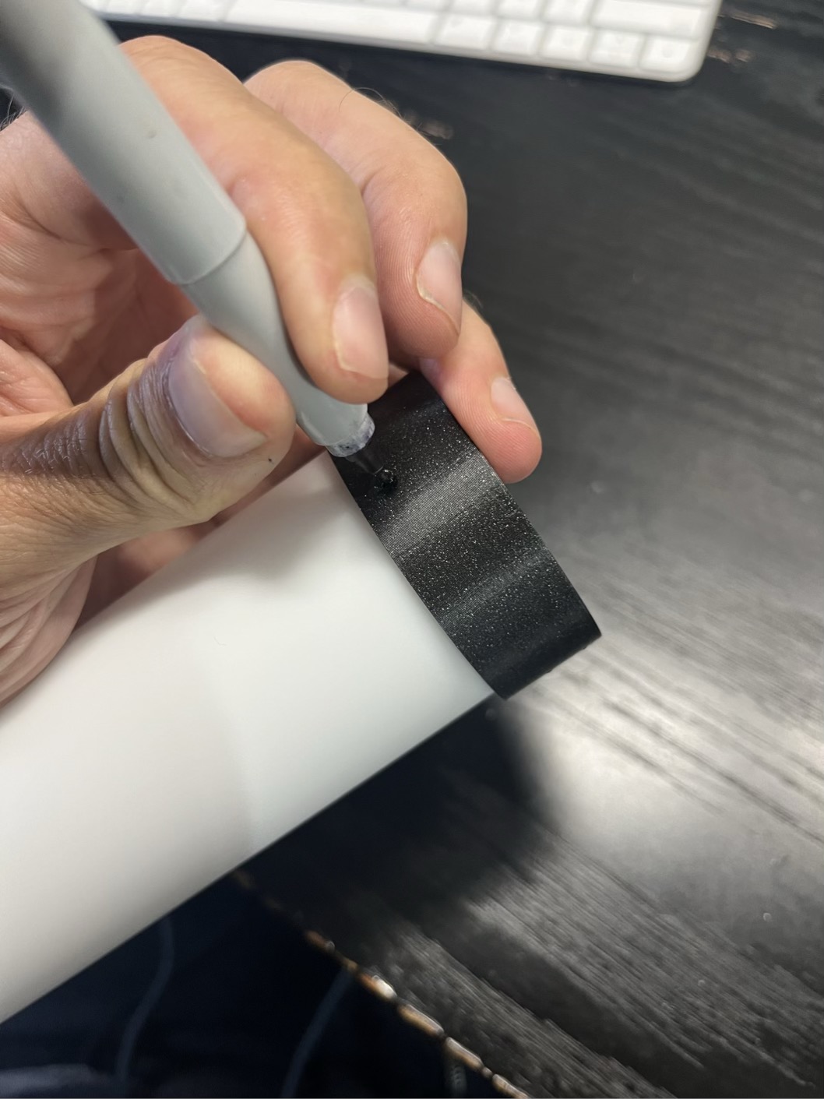
BUILD/LightSticks/TUTORIAL_IMAGES/STEP_01/11--Mark_actylic_tube_hole_placements.jpeg
