EfficiencyJunky/LEDLightSticks/BUILD/LightSticks/TUTORIAL_IMAGES/STEP_01/12--B_Mark_flat_bar_hole_placement.jpeg

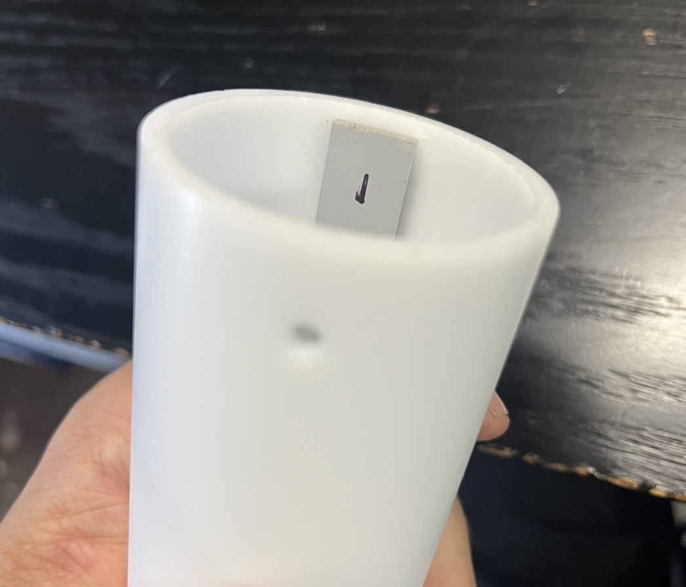
BUILD/LightSticks/TUTORIAL_IMAGES/STEP_01/12--B_Mark_flat_bar_hole_placement.jpeg
