EfficiencyJunky/LEDLightSticks/BUILD/LightSticks/TUTORIAL_IMAGES/STEP_01/14--Mark_flat_bar_10mm_line.jpeg

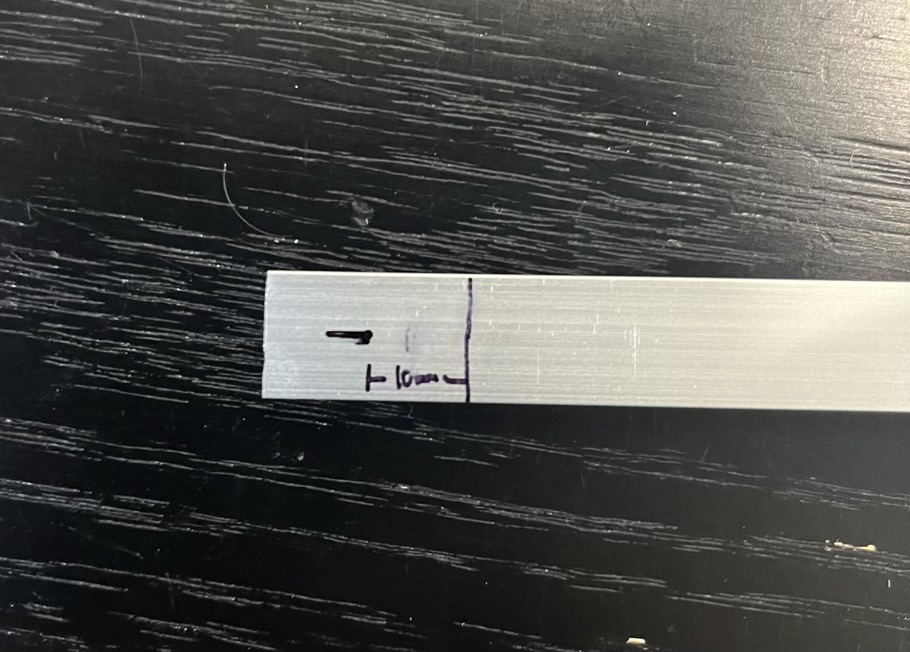
BUILD/LightSticks/TUTORIAL_IMAGES/STEP_01/14--Mark_flat_bar_10mm_line.jpeg
