EfficiencyJunky/LEDLightSticks/BUILD/LightSticks/TUTORIAL_IMAGES/STEP_01/16--Drill_flat_bar.jpeg

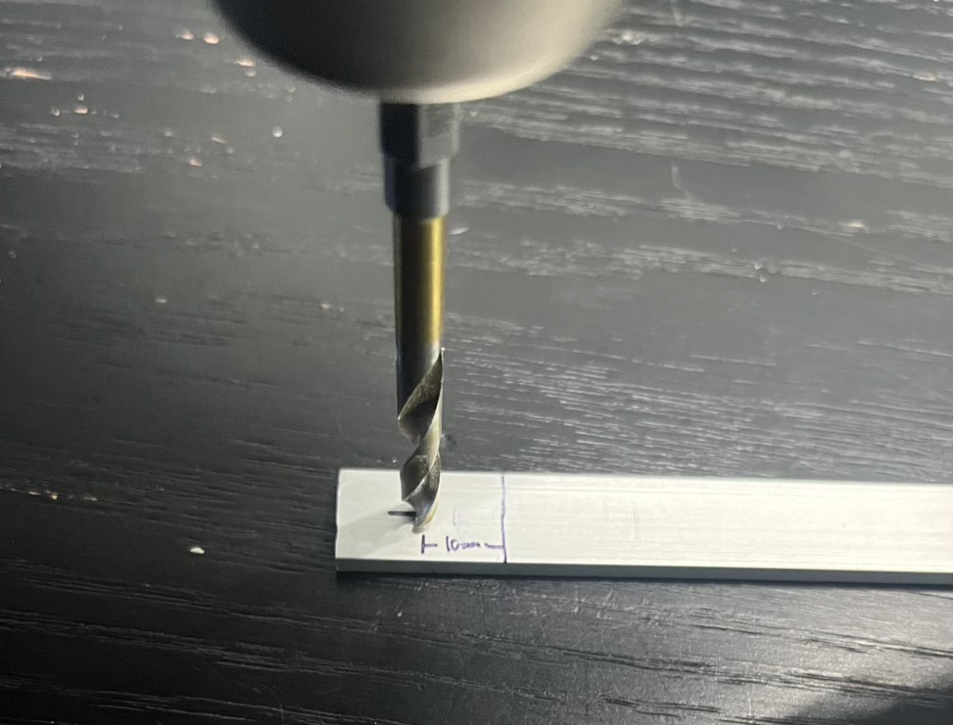
BUILD/LightSticks/TUTORIAL_IMAGES/STEP_01/16--Drill_flat_bar.jpeg
