EfficiencyJunky/LEDLightSticks/BUILD/LightSticks/TUTORIAL_IMAGES/STEP_02/01--B_JSTxhx3_cut.jpeg

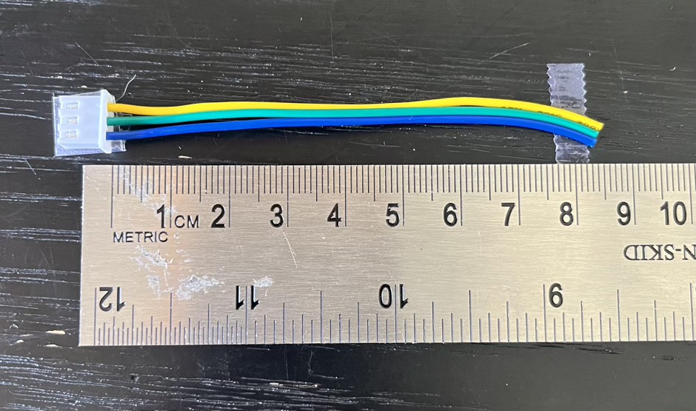
BUILD/LightSticks/TUTORIAL_IMAGES/STEP_02/01--B_JSTxhx3_cut.jpeg
