EfficiencyJunky/LEDLightSticks/BUILD/LightSticks/TUTORIAL_IMAGES/STEP_02/02--JSTxhx3_stripped_and_tinned.jpeg

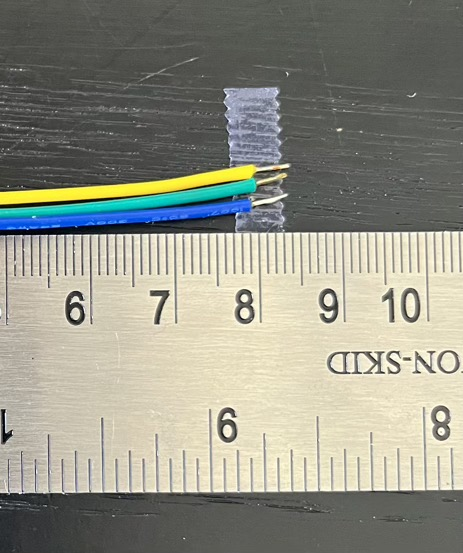
BUILD/LightSticks/TUTORIAL_IMAGES/STEP_02/02--JSTxhx3_stripped_and_tinned.jpeg
