EfficiencyJunky/LEDLightSticks/BUILD/LightSticks/TUTORIAL_IMAGES/STEP_02/04--LED_strip_tinned.jpeg

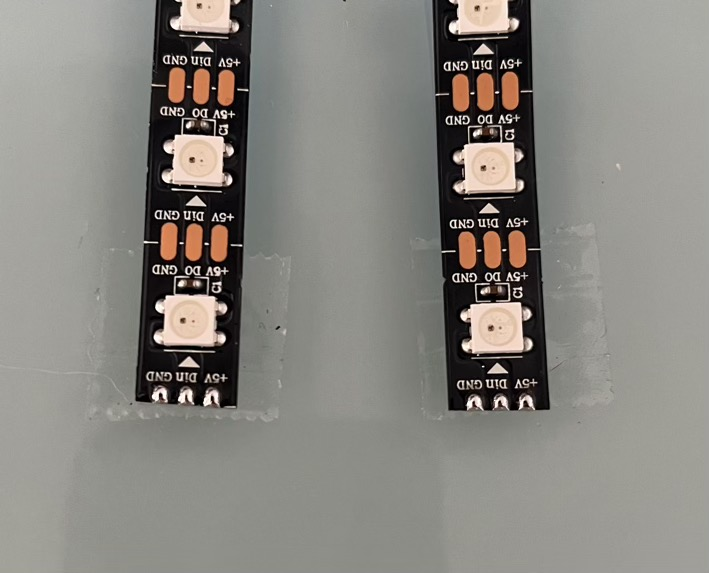
BUILD/LightSticks/TUTORIAL_IMAGES/STEP_02/04--LED_strip_tinned.jpeg
