EfficiencyJunky/LEDLightSticks/BUILD/LightSticks/TUTORIAL_IMAGES/STEP_02/05--HeatShrink_on_wires.jpeg

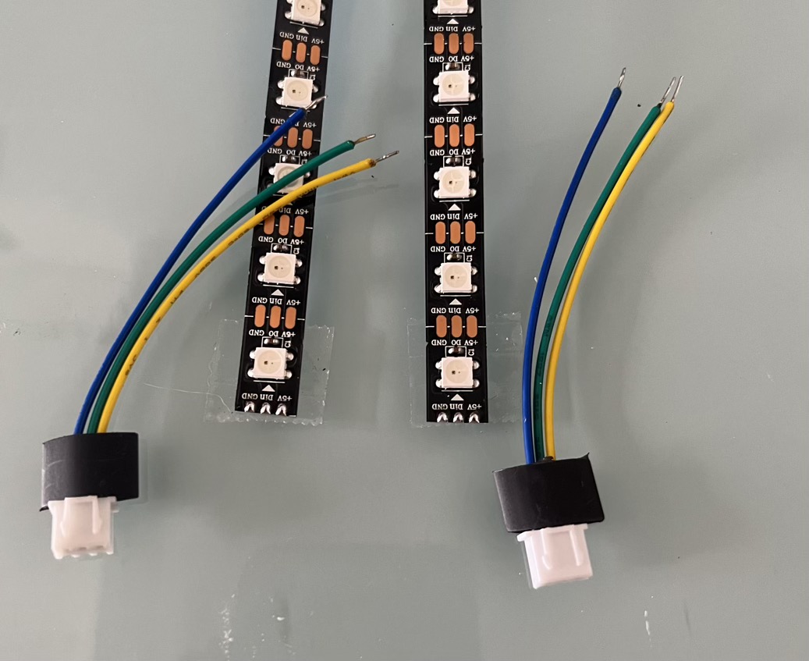
BUILD/LightSticks/TUTORIAL_IMAGES/STEP_02/05--HeatShrink_on_wires.jpeg
