EfficiencyJunky/LEDLightSticks/BUILD/LightSticks/TUTORIAL_IMAGES/STEP_02/06--A_JSTxhx3_solder.jpeg

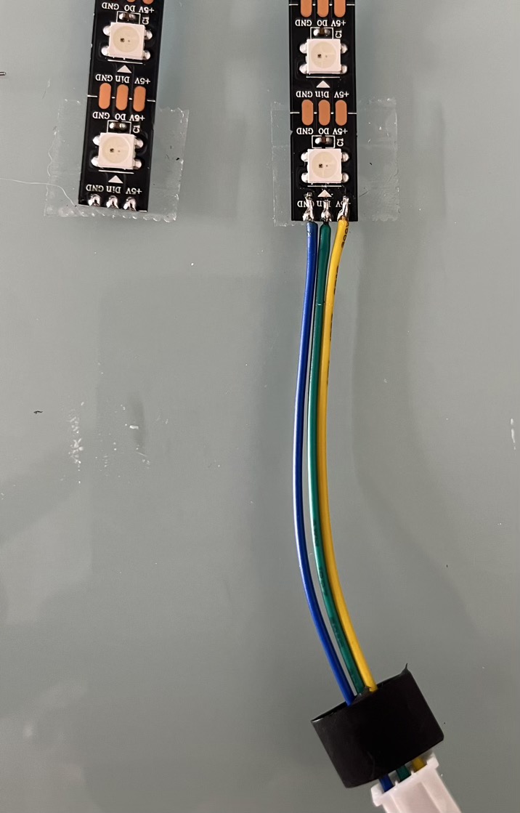
BUILD/LightSticks/TUTORIAL_IMAGES/STEP_02/06--A_JSTxhx3_solder.jpeg
