EfficiencyJunky/LEDLightSticks/BUILD/LightSticks/TUTORIAL_IMAGES/STEP_02/07--A_JSTxhx3_heatshrink.jpeg

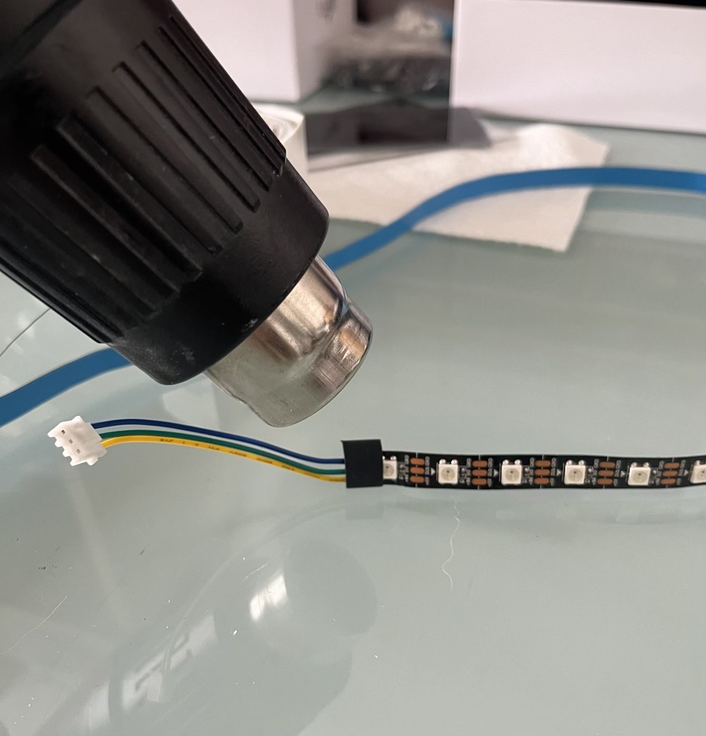
BUILD/LightSticks/TUTORIAL_IMAGES/STEP_02/07--A_JSTxhx3_heatshrink.jpeg
