EfficiencyJunky/LEDLightSticks/BUILD/LightSticks/TUTORIAL_IMAGES/STEP_02/08--B_JSTxhx2_cut.jpeg

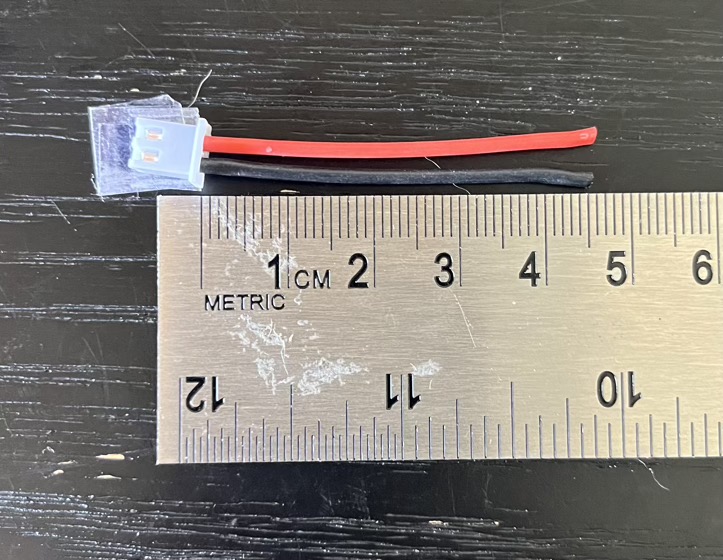
BUILD/LightSticks/TUTORIAL_IMAGES/STEP_02/08--B_JSTxhx2_cut.jpeg
