EfficiencyJunky/LEDLightSticks/BUILD/LightSticks/TUTORIAL_IMAGES/STEP_02/09--JSTxhx2_strip_tinned.jpeg

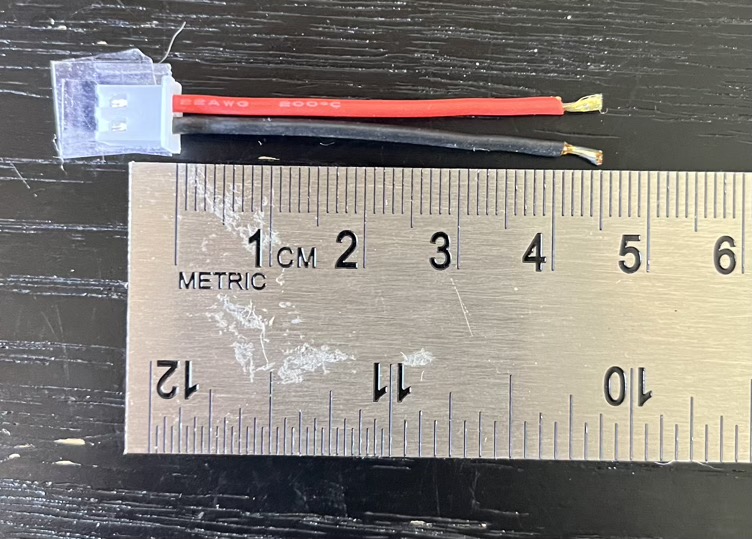
BUILD/LightSticks/TUTORIAL_IMAGES/STEP_02/09--JSTxhx2_strip_tinned.jpeg
