EfficiencyJunky/LEDLightSticks/BUILD/LightSticks/TUTORIAL_IMAGES/STEP_02/10--LED_strip_tinned.jpeg

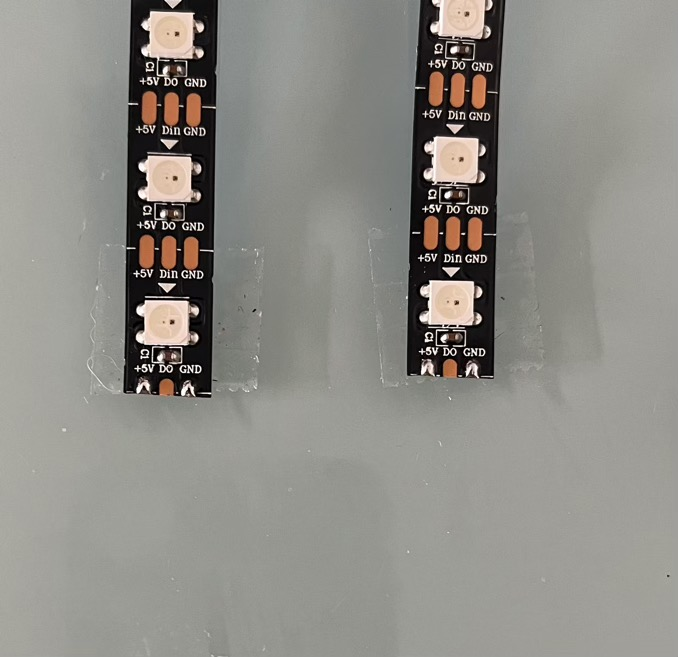
BUILD/LightSticks/TUTORIAL_IMAGES/STEP_02/10--LED_strip_tinned.jpeg
