EfficiencyJunky/LEDLightSticks/BUILD/LightSticks/TUTORIAL_IMAGES/STEP_02/11--HeatShrink_on_wires.jpeg

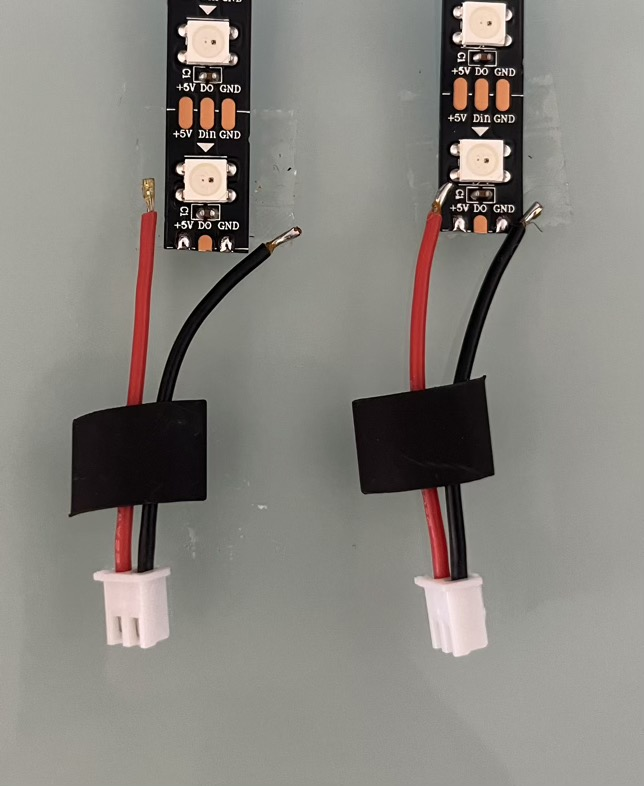
BUILD/LightSticks/TUTORIAL_IMAGES/STEP_02/11--HeatShrink_on_wires.jpeg
