EfficiencyJunky/LEDLightSticks/BUILD/LightSticks/TUTORIAL_IMAGES/STEP_02/12--JSTxhx2_solder.jpeg

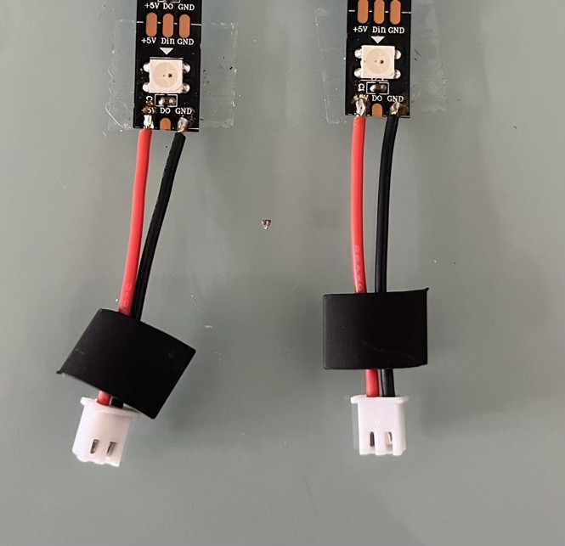
BUILD/LightSticks/TUTORIAL_IMAGES/STEP_02/12--JSTxhx2_solder.jpeg
