EfficiencyJunky/LEDLightSticks/BUILD/LightSticks/TUTORIAL_IMAGES/STEP_02/13--JSTxhx2_heatshrink.jpeg

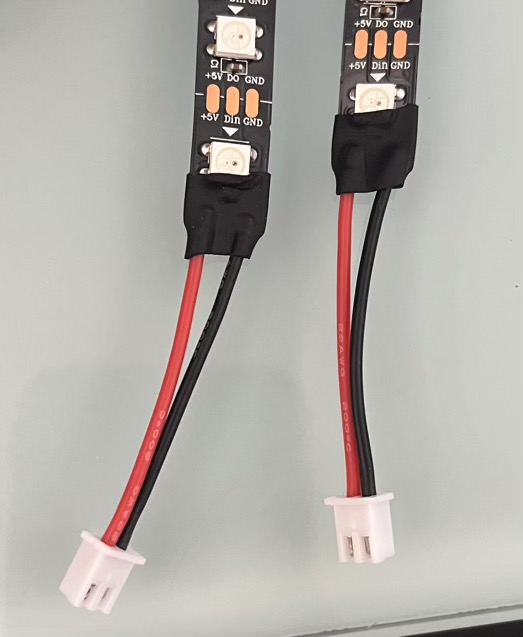
BUILD/LightSticks/TUTORIAL_IMAGES/STEP_02/13--JSTxhx2_heatshrink.jpeg
