EfficiencyJunky/LEDLightSticks/BUILD/LightSticks/TUTORIAL_IMAGES/STEP_02/14--Tape_on_flatbar.jpeg

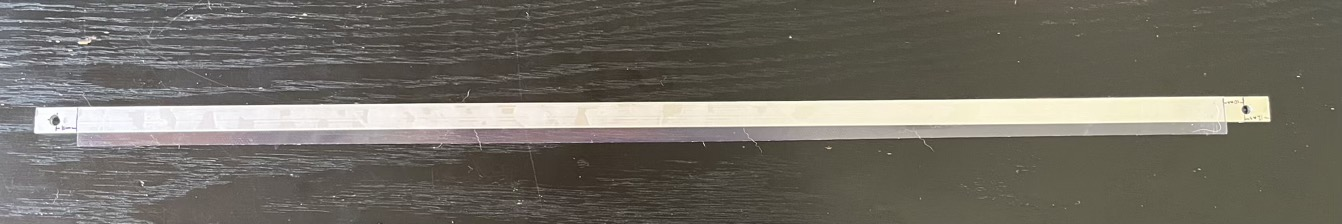
BUILD/LightSticks/TUTORIAL_IMAGES/STEP_02/14--Tape_on_flatbar.jpeg
