EfficiencyJunky/LEDLightSticks/BUILD/LightSticks/TUTORIAL_IMAGES/STEP_02/15--Strip_01_on_flatbar.jpeg

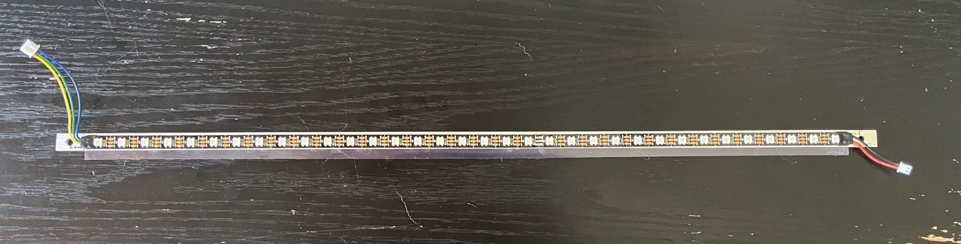
BUILD/LightSticks/TUTORIAL_IMAGES/STEP_02/15--Strip_01_on_flatbar.jpeg
