EfficiencyJunky/LEDLightSticks/BUILD/LightSticks/TUTORIAL_IMAGES/STEP_02/16--A_Strip_02_on_flatbar.jpeg

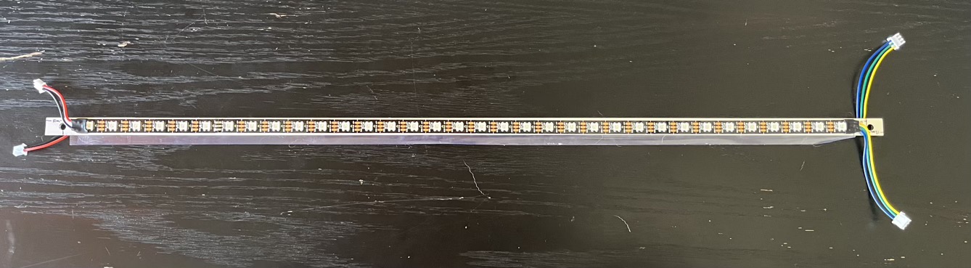
BUILD/LightSticks/TUTORIAL_IMAGES/STEP_02/16--A_Strip_02_on_flatbar.jpeg
