EfficiencyJunky/LEDLightSticks/BUILD/LightSticks/TUTORIAL_IMAGES/STEP_02/16--B_Strips_aligned_on_flatbar.jpeg

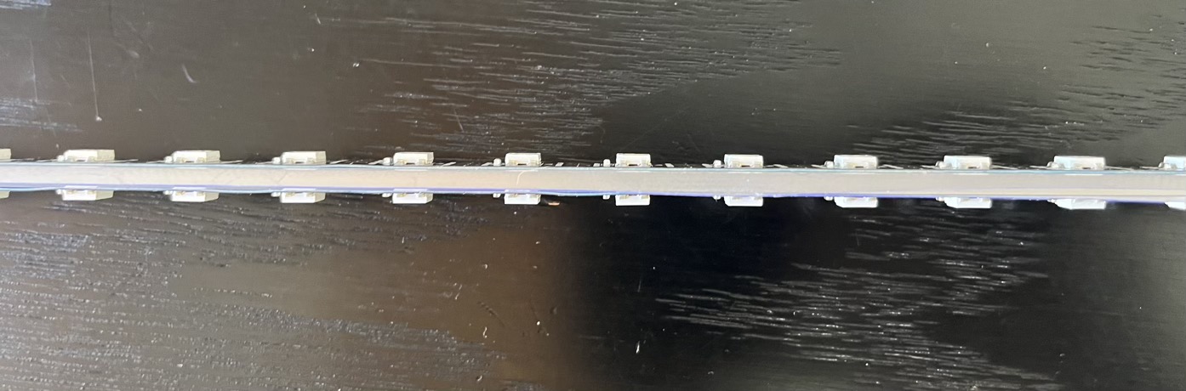
BUILD/LightSticks/TUTORIAL_IMAGES/STEP_02/16--B_Strips_aligned_on_flatbar.jpeg
