EfficiencyJunky/LEDLightSticks/BUILD/LightSticks/TUTORIAL_IMAGES/STEP_02/17--A_LED_assembly_foam_roll.jpeg

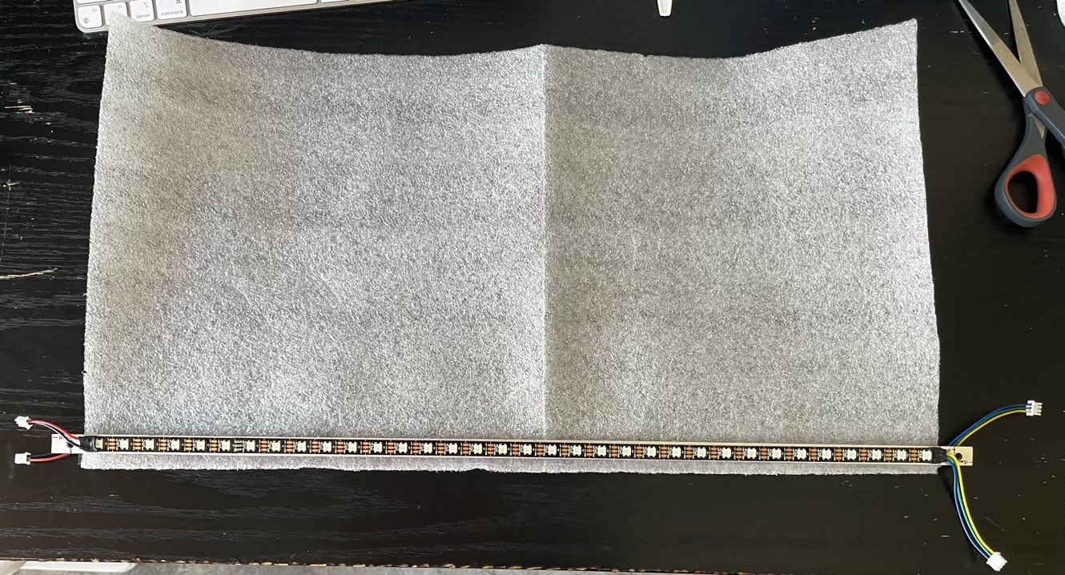
BUILD/LightSticks/TUTORIAL_IMAGES/STEP_02/17--A_LED_assembly_foam_roll.jpeg
