EfficiencyJunky/LEDLightSticks/BUILD/LightSticks/TUTORIAL_IMAGES/STEP_02/18--LED_assembly_foam_roll_taped.jpeg

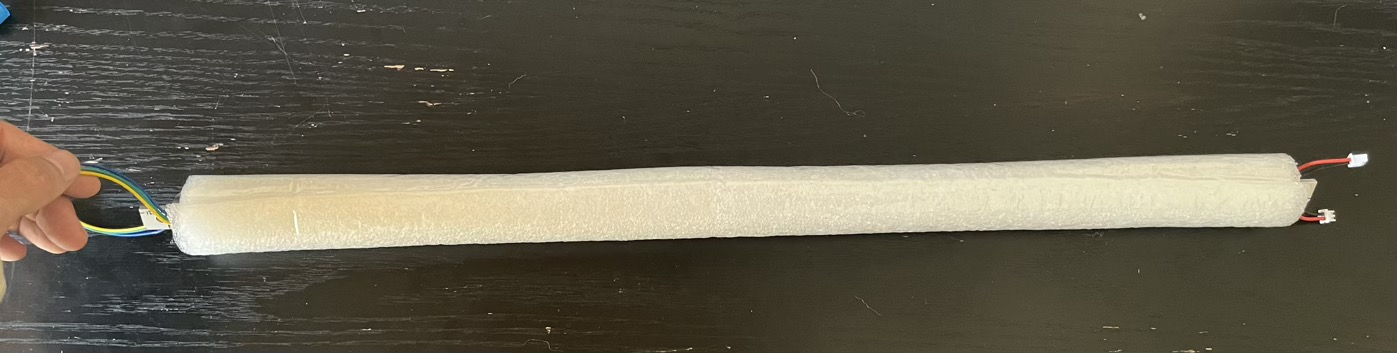
BUILD/LightSticks/TUTORIAL_IMAGES/STEP_02/18--LED_assembly_foam_roll_taped.jpeg
