EfficiencyJunky/LEDLightSticks/BUILD/LightSticks/TUTORIAL_IMAGES/STEP_01/04--test_fitting_of_bolt_and_insert.jpeg

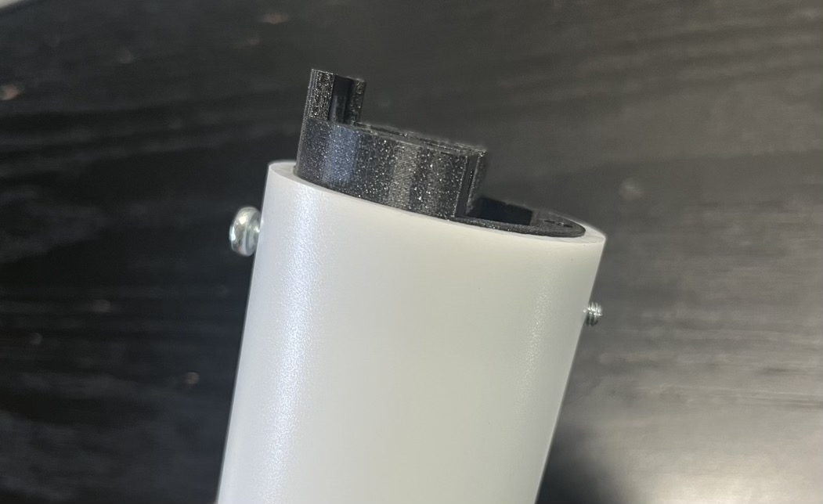
BUILD/LightSticks/TUTORIAL_IMAGES/STEP_01/04--test_fitting_of_bolt_and_insert.jpeg
