EfficiencyJunky/LEDLightSticks/BUILD/LightSticks/TUTORIAL_IMAGES/STEP_01/17--A_Test_fitment_side01.jpeg

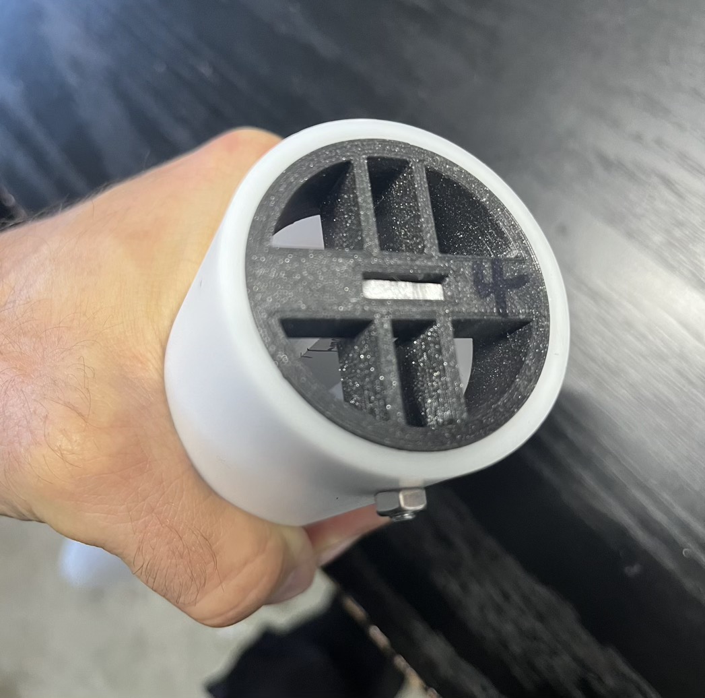
BUILD/LightSticks/TUTORIAL_IMAGES/STEP_01/17--A_Test_fitment_side01.jpeg
