EfficiencyJunky/LEDLightSticks/BUILD/LightSticks/TUTORIAL_IMAGES/STEP_01/17--B_Test_fitment_side02.jpeg

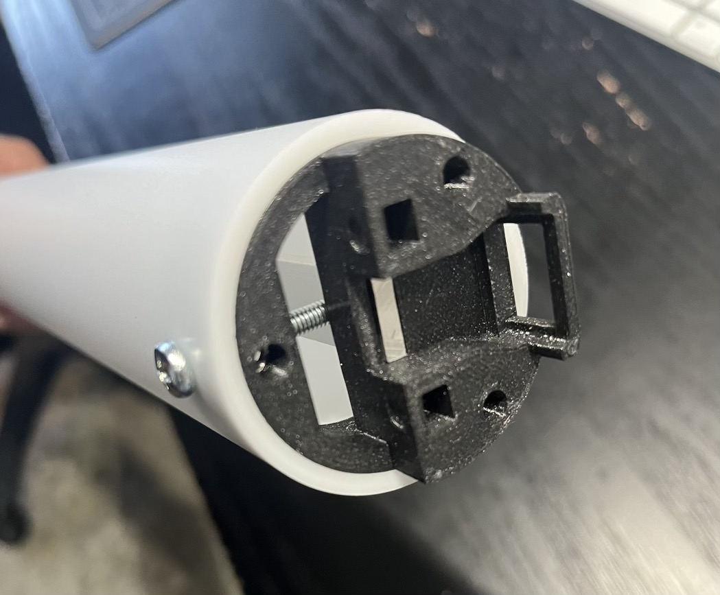
BUILD/LightSticks/TUTORIAL_IMAGES/STEP_01/17--B_Test_fitment_side02.jpeg
