EfficiencyJunky/LEDLightSticks/BUILD/LightSticks/TUTORIAL_IMAGES/STEP_02/01--A_JSTxhx3_measure.jpeg

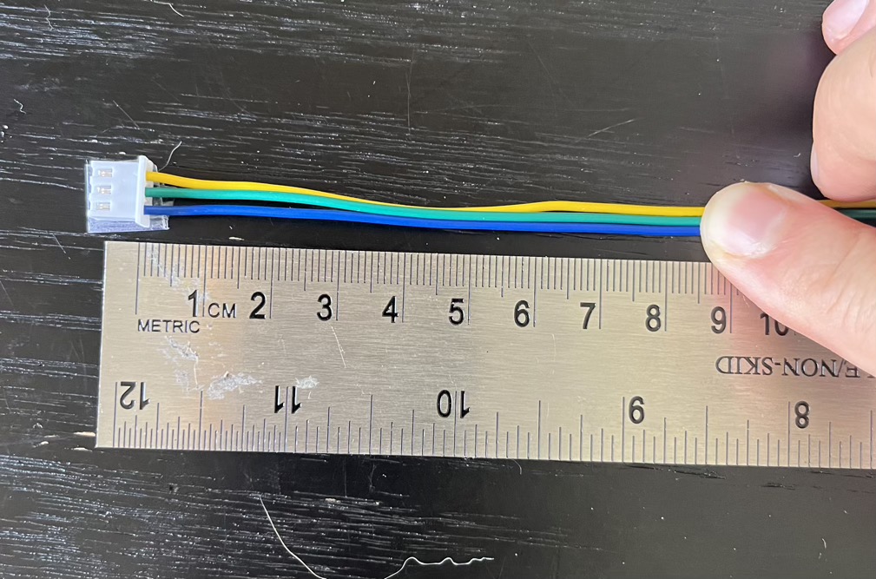
BUILD/LightSticks/TUTORIAL_IMAGES/STEP_02/01--A_JSTxhx3_measure.jpeg
