EfficiencyJunky/LEDLightSticks/BUILD/LightSticks/TUTORIAL_IMAGES/STEP_02/08--A_JSTxhx2_measure.jpeg

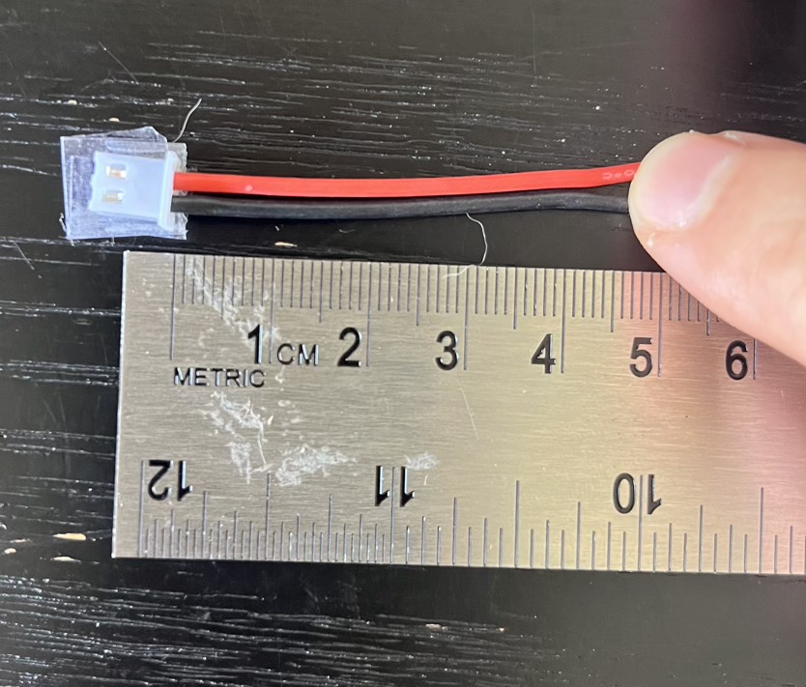
BUILD/LightSticks/TUTORIAL_IMAGES/STEP_02/08--A_JSTxhx2_measure.jpeg
