EfficiencyJunky/LEDLightSticks/BUILD/LightSticks/TUTORIAL_IMAGES/STEP_02/19--A_testing_LEDs.jpeg

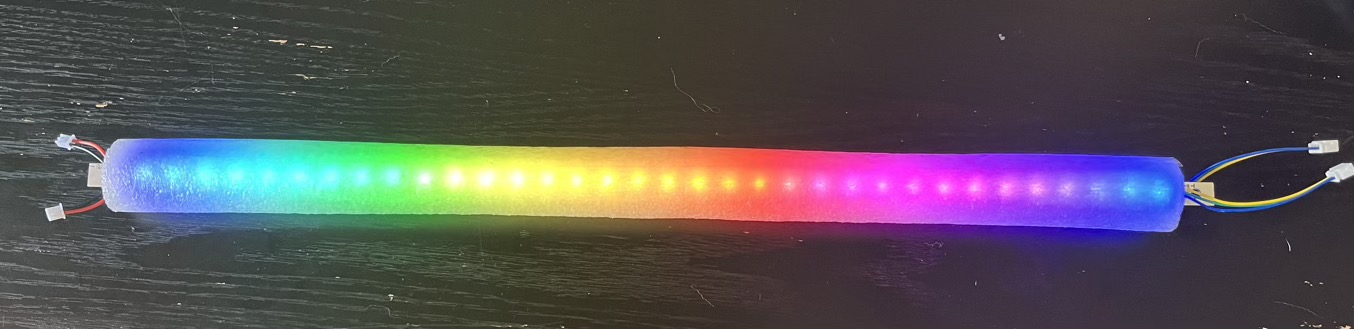
BUILD/LightSticks/TUTORIAL_IMAGES/STEP_02/19--A_testing_LEDs.jpeg
