EfficiencyJunky/LEDLightSticks/(threads)

Thread 1 (2020-10-22):

Create PCB for USB to Molex connector

EfficiencyJunky, 2020-10-22:
you know what to do

EfficiencyJunky, 2020-10-22:
First I need to create all the Molex Micro-Fit connectors in Eagle Library format

EfficiencyJunky, 2020-10-22:
* Vertical Male (for connection in handle): [Molex Connector Part Number - 44432-0401](https://www.molex.com/molex/products/part-detail/pcb_headers/0444320401)
* Vertical Female (for connection in stand): [Molex Connector Part Number - 44769-0401](https://www.molex.com/molex/products/part-detail/pcb_receptacles/0447690401)
* R/A Female (for connection on USB board): [Molex Connector Part Number - 44764-0401](https://www.molex.com/molex/products/part-detail/pcb_receptacles/0447640401)

EfficiencyJunky, 2020-10-22:
The item needing creation for the USB board is this one: https://www.digikey.com/en/products/detail/molex/0447640401/513244?s=N4IgTCBcDaIAwBYEHYBsDFwIwgLoF8g

EfficiencyJunky, 2020-10-22:
Finished making library part for RA Male Molex MicroFit

EfficiencyJunky, 2020-10-22:
Finished PCB

Closed 2020-10-22.

Thread 2 (2020-10-22):

Create LED Stick power plug and assembly

EfficiencyJunky, 2020-10-22:
Make library component, pcb breakout board, and internal mounting stucture for the Micro-Fit Male straight header that will mate with the power source boards

EfficiencyJunky, 2020-10-22:
Here's the part on DigiKey: https://www.digikey.com/en/products/detail/molex/0444320401/513230?s=N4IgTCBcDaIAwBYkGYyLgRhAXQL5A

Here's the Dimensional Drawing: https://www.molex.com/pdm_docs/sd/444320401_sd.pdf

EfficiencyJunky, 2020-10-22:
Finished making part for library

EfficiencyJunky, 2020-10-22:
Finished creating PCB and adding it to design. Still need to create structural supports

EfficiencyJunky, 2020-10-23:
finished creating structural supports

Closed 2020-10-23.

Thread 7 (2020-12-26):

Add speed change functionality in Settings mode

EfficiencyJunky, 2020-12-26:

EfficiencyJunky, 2020-12-27:
Also figure out if we can fix the issue where the wav jumps when the BPM changes

EfficiencyJunky, 2020-12-27:
issue resolved in commit: https://github.com/EfficiencyJunky/LEDLightSticks/commit/fcc7cff4ce26bba3d40ecebf31141d1d67b8d3c4

Closed 2020-12-27.

Thread 10 (2020-12-27):

add ability to save settings to EEPROM

EfficiencyJunky, 2020-12-27:
Resources:
https://www.arduino.cc/en/Reference/EEPROM
https://www.pjrc.com/teensy/td_libs_EEPROM.html
https://learn.sparkfun.com/tutorials/reading-and-writing-serial-eeproms/all
http://www.mosaic-industries.com/embedded-systems/sbc-single-board-computers/freescale-hcs12-9s12-c-language/instrument-control/eeprom-lifetime-reliability-wear-leve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

Arduino Leonardo has 1024 bytes of EEPROM
Teensy has 2048 bytes of EEPROM

We should only use 1024 or 512 or set the EEPROM as one of the hardware settings

**NOTE**
Each address contains one byte of information in the form of an unsigned byte, which is best represented as uint8_t so we can easily just use uint8_t data types for each memory location
more information here:
https://docs.oracle.com/cd/E19253-01/817-6223/chp-typeopexpr-2/index.html
https://forum.arduino.cc/index.php?topic=206959.0

EfficiencyJunky, 2020-12-28:
Added a new .ino file that prepares the EEPROM to be used to save settings
in this commit: https://github.com/EfficiencyJunky/LEDLightSticks/commit/b251ee782d3e4ee2d17954b45086c1bdb37d0709

EfficiencyJunky, 2020-12-28:
resolved with commit: https://github.com/EfficiencyJunky/LEDLightSticks/commit/f8e047853a4a808bb2f014330ee3452d1baeaeb4

Closed 2020-12-28.

Thread 8 (2020-12-27):

tweak palette animation so that it fits old led sticks

EfficiencyJunky, 2020-12-27:

EfficiencyJunky, 2020-12-27:
apparently all that needed to be done is to set the 7 from the fill_palette() function used in the rainbow animation to 3 LOL!!!
and adjusted the BPM for palettes to be +3 that of rainbow. so lowest speed is 16bpm

EfficiencyJunky, 2020-12-27:
issue resolved in commit: https://github.com/EfficiencyJunky/LEDLightSticks/commit/71703f970f24867ca3743a129fe56b5701d15fa3

Closed 2020-12-27.

Thread 9 (2020-12-27):

add fire, bpm, and juggle animations

EfficiencyJunky, 2020-12-27:

EfficiencyJunky, 2020-12-28:
resolved in commit: https://github.com/EfficiencyJunky/LEDLightSticks/commit/692b00799cf94eff4e59ff84d635397ff7494304

Closed 2020-12-28.

Thread 12 (2020-12-30):

Setup Fire Animation with specific palettes

EfficiencyJunky, 2020-12-30:
Only a few specific animations look good on Fire animation. We need to create a color palette array specifically for Fire and keep track of the animations in EEPROM

EfficiencyJunky, 2020-12-31:
issue resolved in commit: https://github.com/EfficiencyJunky/LEDLightSticks/commit/5aa492694c529720c362f9a5b9cb9be25700e1b1

Closed 2020-12-31.

Thread 13 (2020-12-30):

Add long press of secondary button to display current color palette

EfficiencyJunky, 2020-12-30:
It would be cool to have a menu option where pressing and holding the secondary (color) button takes the user to a mode where they can see the current palette and cycle through all available palettes.

Ideally they could turn the palette on or off as well.

EfficiencyJunky, 2020-12-31:
resolved in commit: https://github.com/EfficiencyJunky/LEDLightSticks/commit/f9a25eddb248bfec800b196eefd7424be849945a

Closed 2020-12-31.

Thread 14 (2020-12-30):

Finish structuring program and all EEPROM data to save

EfficiencyJunky, 2020-12-30:
Need to get final structure of program figured out
1. Order of Animations
2. Order of Color Palettes and which palettes go with which animations
3. Fire Animation with it's own set of palettes
4. Finish colorwaves animation with non-static variables
4. Menu for color palette checking
5. EEPROM settings update

Animations with separate palettes:
* Rainbow (rainbow only)
* Fire (only fire palettes)
* Solid Color (only solid colors)
* ColorWaves (should it have its own?)
* All other animations

EfficiencyJunky, 2020-12-31:
updated way we're storing settings in EEPROM. Now using Struct to store all settings.

commit: https://github.com/EfficiencyJunky/LEDLightSticks/commit/42dcc3da1ae20d90a04cf422e580c087e9eaa728

EfficiencyJunky, 2020-12-31:
Updated fire animation to only use firepalettes
https://github.com/EfficiencyJunky/LEDLightSticks/commit/5aa492694c529720c362f9a5b9cb9be25700e1b1

EfficiencyJunky, 2020-12-31:
Updated colorwaves animation to no longer use static variables
https://github.com/EfficiencyJunky/LEDLightSticks/commit/5aa492694c529720c362f9a5b9cb9be25700e1b1

EfficiencyJunky, 2020-12-31:
added menu for palette checking (longpress palette button) and fixed issues with Colorwaves animation
https://github.com/EfficiencyJunky/LEDLightSticks/commit/f9a25eddb248bfec800b196eefd7424be849945a

EfficiencyJunky, 2021-01-02:
YAY!! Finally finished with commit: https://github.com/EfficiencyJunky/LEDLightSticks/commit/7bcde5b0ab891b25fe082626b4e848705f927d31

EfficiencyJunky, 2021-01-02:
ok NOW it's finally finished with commit: https://github.com/EfficiencyJunky/LEDLightSticks/commit/6093ef3a8d982d1d876b0622f67dbc94c47ebb2e

EfficiencyJunky, 2021-01-02:
one more contribution (added random seed number) in commit: https://github.com/EfficiencyJunky/LEDLightSticks/commit/3dcee9bdafc98c1f5235235f68db5be460e0e3ed

Closed 2021-01-02.

Thread 15 (2020-12-30):

Add array index variables for all arrays (palettes and animations)

EfficiencyJunky, 2020-12-30:

EfficiencyJunky, 2020-12-31:
resolved in commit: https://github.com/EfficiencyJunky/LEDLightSticks/commit/42dcc3da1ae20d90a04cf422e580c087e9eaa728

Closed 2020-12-31.

Thread 16 (2020-12-31):

Move settings initializations to initializeAnimation() function

EfficiencyJunky, 2020-12-31:
we only want to store a single CRGBPalette16 color palette in the program memory at once and swap it out depending on the animation settings. So we can just store the index in our settings object for each animation and then swap the palette being used in the initializeAnimation() function

EfficiencyJunky, 2020-12-31:
issue resolved in commit: https://github.com/EfficiencyJunky/LEDLightSticks/commit/5aa492694c529720c362f9a5b9cb9be25700e1b1

Closed 2020-12-31.

Thread 17 (2020-12-31):

Implement LFO to recreate "Devin Animation"

EfficiencyJunky, 2020-12-31:
need a struct {
   rate  = BPM from 30 - 100
   depth = 70 - 100
   base = 80 - 140
}

also need global scalar

and usecase would be beatsin8(rate*scalar, base, base+depth)

this would be used as brightness

EfficiencyJunky, 2021-01-02:
mostly resolved issue with commit: https://github.com/EfficiencyJunky/LEDLightSticks/commit/0be6cdf90f51bb84d792e1ebf8ae290c71474d39

Closed 2021-01-02.

Thread 18 (2020-12-31):

Add way to turn off lights that don't have switch

EfficiencyJunky, 2020-12-31:
Hold both buttons down to turn off

EfficiencyJunky, 2020-12-31:
resolved although not great code in commit: https://github.com/EfficiencyJunky/LEDLightSticks/commit/0430eb7a98b0247ba3cfefa91953f58c73fecc4e

Closed 2020-12-31.

Thread 20 (2021-01-02):

Tighten tolerances around acrylic tube

EfficiencyJunky, 2021-01-02:

EfficiencyJunky, 2021-01-02:
tightened tolerance for bottom sheeth in V2p2 v94

EfficiencyJunky, 2021-01-03:
tightened tolerance for top sheeth in V2p2 v98

EfficiencyJunky, 2021-01-04:
tested prints and seems to work for both top and bottom

Closed 2021-01-04.

Thread 22 (2021-01-02):

tighten tolerances around battery

EfficiencyJunky, 2021-01-02:

EfficiencyJunky, 2021-01-02:
completed in V2p2 v92

EfficiencyJunky, 2021-01-02:
accidentally added new bodies to main sheeth component parent instead of the actual main sheeth component so fixed this in V2p2 v96

Closed 2021-01-02.

Thread 27 (2021-01-02):

Tighten main bolt nut holder cutouts

EfficiencyJunky, 2021-01-02:

EfficiencyJunky, 2021-01-02:
Tightened nut holder for bottom sheeth from 8.4 to 8.0 and 9.7 to 9.2

EfficiencyJunky, 2021-01-03:
Tightened nut holder for top sheeth from 8.4 to 8.0 and 9.7 to 9.2 in revision V2p2 v100

Closed 2021-01-03.

Thread 32 (2021-01-04):

Add power cutoff for programming to PCB#1

EfficiencyJunky, 2021-01-04:
We need to redesign the brain board slightly so that it can be programmed more easily while connected to the led light sticks, can control the 2 strips individually, and adheres to the color codes of the harnesses we're using

1. Add power cutoff for programming
2. add second LED Strip data connection to PCB1 and Blinky Tape
2. Swap positive and negative power connections

**PARTS**
200 Ohm Resistor (1206 SMD): https://www.digikey.com/en/products/detail/stackpole-electronics-inc/RMCF1206FT200R/1759762
0 Ohm Resistor (1206 SMD): https://www.digikey.com/en/products/detail/stackpole-electronics-inc/RMCF1206ZT0R00/1756906
Jumper (shorting connector): https://www.digikey.com/en/products/detail/sullins-connector-solutions/QPC02SXGN-RC/2618262

EfficiencyJunky, 2021-01-04:
First need to make new footprint for BlinkyTape

EfficiencyJunky, 2021-01-05:
finished adding Blinky Tape and 3Pos JST-HX connectors in Library V54

EfficiencyJunky, 2021-01-05:
Pad Dimensions for https://www.digikey.com/en/products/detail/stackpole-electronics-inc/RMCF1206FT200R/1759762
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

EfficiencyJunky, 2021-01-05:
finished adding 3 way resistor in version 56

EfficiencyJunky, 2021-01-05:
Resolved in Library version 56 and PCB1 Schematic V2p2 V2

Closed 2021-01-05.

Thread 37 (2021-01-06):

Update mounting holes and nut seats to match M4 hardware dimensions

EfficiencyJunky, 2021-01-06:
We want to test if M4 hardware works better than the previous 10-32 hardware for mounting bolts

Things to adjust:
1. Mounting Bolt hole diameter -> 4mm
2. Mounting Bolt Head Diameter -> 8mm + Gap
3. Mounting Nut Width -> 7mm
4. Mounting Nut Depth -> 3.2mm + Gap
5. D-Ring clearance -> drop the height of the outer shell from 1mm to 0.2mm -> Add 2mm fillet to inside lip

EfficiencyJunky, 2021-01-06:
**10-32 Bolt and nut dimensions:**
10-32 Bolt Diameter: 0.19 inch -> mounting_bolt_diameter
10-32 Clearance hole diameter: 5mm -> mounting_bolt_clearance_hole_diameter_10_32
10-32 Nut width: 8mm -> nut_10_32_width
10-32 Nut height: 2.8mm -> nut_10_32_height
10-32 Bolt Head Diameter: 9.5mm -> mounting_bolt_head_diameter

**M4 Bolt and nut dimensions:**
Bolt: https://www.mcmaster.com/92005A242/
Nut: https://www.mcmaster.com/91828A231/

M4 Bolt Diameter: 4mm (3.8mm measured)
M4 Clearance hole diameter: 4mm -> M4_mounting_bolt_clearance_hole_diameter
M4 Nut width: 7mm -> M4_mounting_nut_width
M4 Nut height: 3.2mm -> M4_mounting_nut_height
M4 Bolt Head Diameter: 8mm -> M4_mounting_bolt_head_diameter

EfficiencyJunky, 2021-01-07:
TOP -- finished top mounting hole and nut updates and fillet on d-ring cutout in V115

EfficiencyJunky, 2021-01-07:
All M4 Updates complete in V117

Closed 2021-01-07.

Thread 38 (2021-01-10):

Re-create battery securing clip. flip back to original side but make smaller

EfficiencyJunky, 2021-01-10:

Thread 39 (2021-01-15):

Test issue with Max

EfficiencyJunky, 2021-01-15:
here's a description

EfficiencyJunky, 2021-01-15:
this issue includes changes from commit: https://github.com/EfficiencyJunky/LEDLightSticks/commit/1ea6fb3319056a4e72e4bc6f552e10ae19aae416

Thread 40 (2021-01-22):

Update spacing around button holes to be slightly wider and flare out the part that encompases the button

EfficiencyJunky, 2021-01-22:
Sometimes if the top gets bumped, the button will be clicked so we want to avoid this by putting a little more space around the button and only have a tiny bit of the cover actually come close to it

EfficiencyJunky, 2021-01-23:
Complete in V125

Closed 2021-01-23.
