EfficiencyJunky/LEDLightSticks/ELECTRONICS/PCB/V2p0/EAGLE_files/brd/LEDLightSticks_V2--01--Brain_Board_PCB_v17.brd

## EAGLE design ELECTRONICS/PCB/V2p0/EAGLE_files/brd/LEDLightSticks_V2--01--Brain_Board_PCB_v17.brd (2020-11-02)

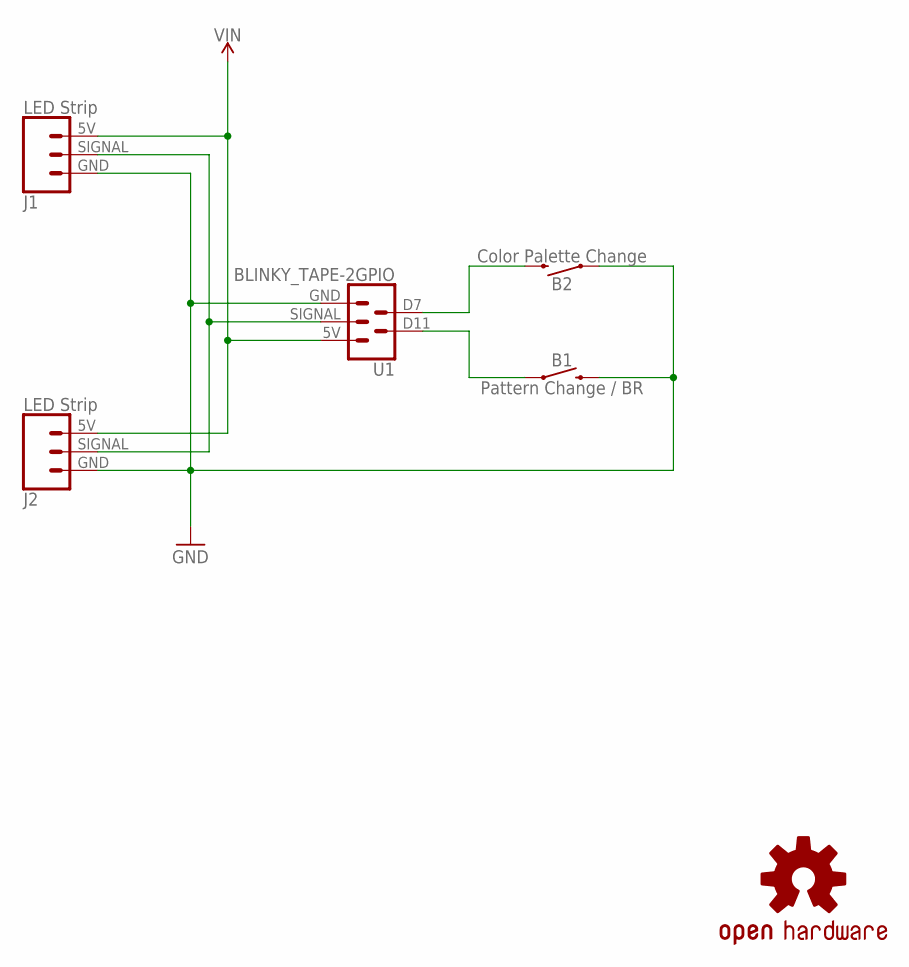
[picture p80: schematic LEDLightSticks_V2--01--Brain_Board_PCB_v11.sch]

Parts:
B1: Pattern Change / BR; TACTILE_SWITCH_PTH_12MM
B2: Color Palette Change; TACTILE_SWITCH_PTH_12MM
J1, J2: LED Strip; JST-3-PTH-XH-RA
LOGO1: OSHW-LOGOM; OSHW-LOGO-M
U1: BLINKY_TAPE-2GPIO

Connections:
GND: B1.3 (2), B2.1, J1.GND (3), J2.GND (3), U1.GND
unnamed: J1.SIGNAL (2), J2.SIGNAL (2), U1.SIGNAL
unnamed: B1.1, U1.D11
unnamed: B2.3 (2), U1.D7
VIN: J1.5V (1), J2.5V (1), U1.5V

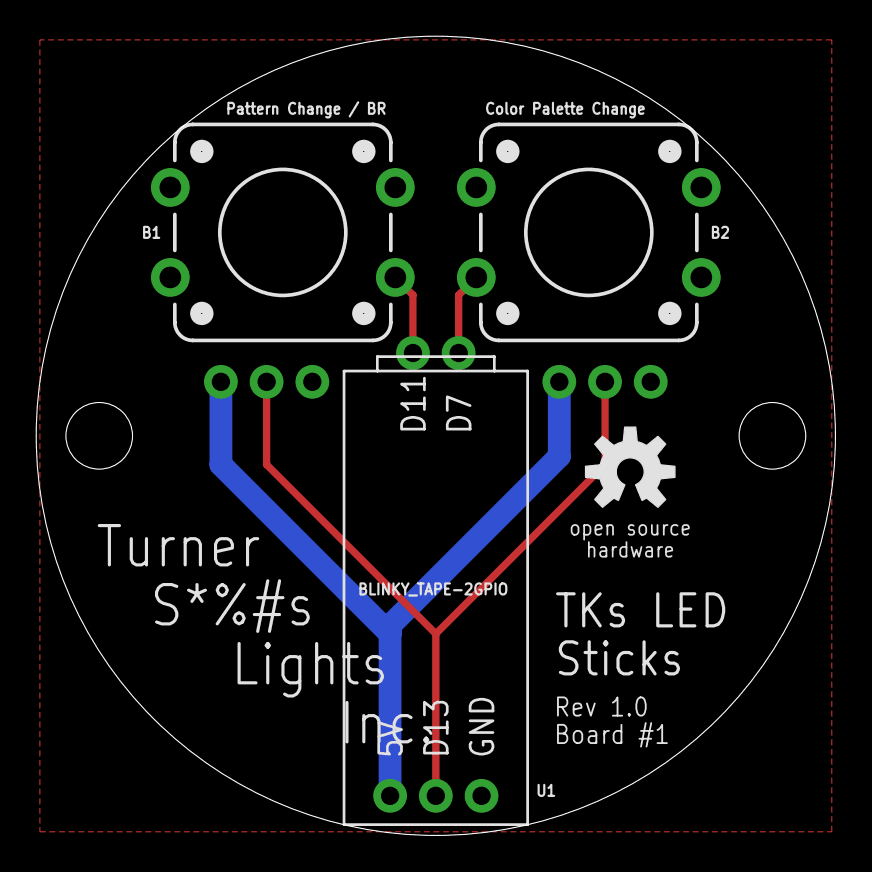
[picture p81: board LEDLightSticks_V2--01--Brain_Board_PCB_v17.brd from above]

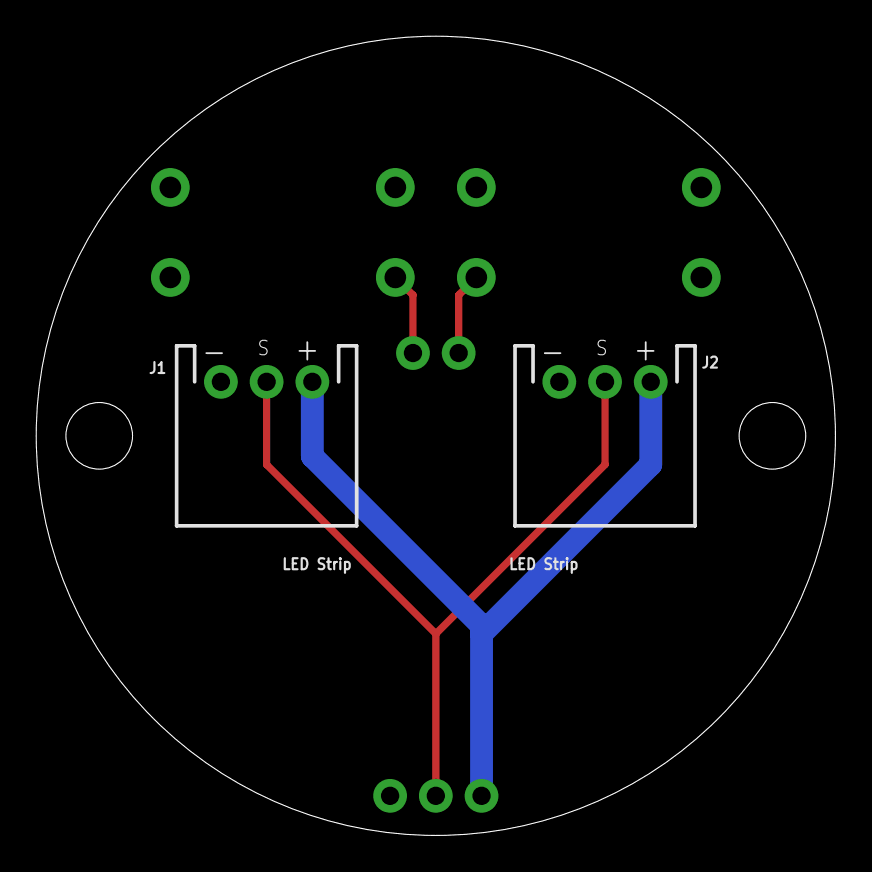
[picture p82: board LEDLightSticks_V2--01--Brain_Board_PCB_v17.brd from below]

Board: 2 copper layers, 44.4 x 44.4 mm, 6 parts (2 on the bottom side), 5 nets.
