EfficiencyJunky/LEDLightSticks/ELECTRONICS/PCB/V2p0/EAGLE_files/brd/LEDLightSticks_V2--02--Power_Dist_PCB_v10.brd

## EAGLE design ELECTRONICS/PCB/V2p0/EAGLE_files/brd/LEDLightSticks_V2--02--Power_Dist_PCB_v10.brd (2020-11-02)

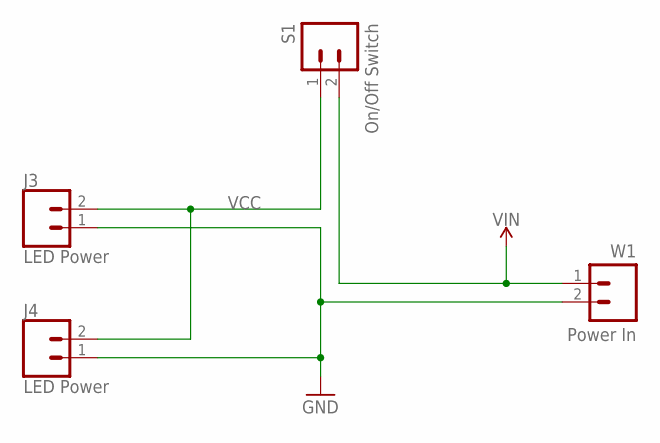
[picture p83: schematic LEDLightSticks_V2--02--Power_Dist_PCB_v3.sch]

Parts:
J3, J4: LED Power; JST-2-PTH-XH-RA
S1: On/Off Switch; 1X02_1.5MM
W1: Power In; 1X02_1.5MM

Connections:
GND: J3.1, J4.1, W1.2
VCC: J3.2, J4.2, S1.1
VIN: S1.2, W1.1

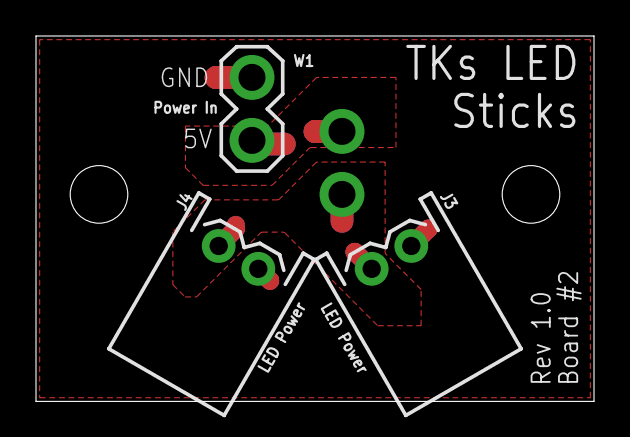
[picture p84: board LEDLightSticks_V2--02--Power_Dist_PCB_v10.brd from above]

Board: 2 copper layers, 31.0 x 20.3 mm, 4 parts (1 on the bottom side), 3 nets.
