EfficiencyJunky/LEDLightSticks/(commit log)

2020-11-02 finished V1p0 of Electronics Designs
    [LEDLightSticks_V2--01--Brain_Board_PCB_v11.sch, LEDLightSticks_V2--01--Brain_Board_PCB_v17.brd, LEDLightSticks_V2--02--Power_Dist_PCB_v10.brd, LEDLightSticks_V2--02--Power_Dist_PCB_v3.sch, LEDLightSticks_V2--03--Molex_Male_BMI_Breakout_PCB_v17.brd, LEDLightSticks_V2--03--Molex_Male_BMI_Breakout_PCB_v5.sch, LEDLightSticks_V2--04--USB_to_Molex_PCB_v15.sch, LEDLightSticks_V2--04--USB_to_Molex_PCB_v2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]
2020-11-04 added some enclosure 3d models
    [bottom_sheeth_main_V1.3mf, bottom_sheeth_main_V1_no_supports.stl, bottom_sheeth_main_V1_supports.stl]
2020-12-22 Added some 3D Models and started working on code
    [V1--BASE--main.stl, V1--BASE.3mf, V1--BOTTOM--battery_securing_clip.stl, V1--BOTTOM--foundation_insert.stl, V1--BOTTOM--sheeth_cap.stl, V1--BOTTOM--sheeth_main--no_supports.stl, V1--BOTTOM--sheeth_main--supports.stl, V1--BOTTOM.3mf]
2020-12-23 Finished initial structure of LEDStripController Class
2020-12-23 tested and fixed some minor "warning" type issues in class implementation
    [LEDLightSticks-BlinkyTape.ino, LEDLightSticks.h, LEDStripController.cpp, LEDStripController.h]
2020-12-25 added fill_palette for rainbow, speed control, and fixed issues
    [HardwareDefinitions.h, LEDLightSticks-BlinkyTape.ino, LEDStripController.cpp, LEDStripController.h]
2020-12-27 added speed control and tweaked all current animations
2020-12-31 added longpress of secondary button to show/scroll palettes and fixed colorwaves bugs
    [LEDLightSticks-BlinkyTape.ino, LEDStripController.cpp, LEDStripController.h]
2020-12-31 fixed issue when in SHOW_PALETTE mode with SOLID_COLOR animation
    [LEDStripController.cpp]
2020-12-31 added ability to turn LED strip off when there's no off button
2021-01-02 fixed a minor issue and replaced A_RAINBOW with A_PALETTE
    [LEDStripController.cpp]
2021-01-05 added ability to address each strip individually. updated code/pcb1
    [LEDLightSticks_V2--01--Brain_Board_PCB_v11.sch, LEDLightSticks_V2--01--Brain_Board_PCB_v17.brd, LEDLightSticks_V2--02--Power_Dist_PCB_v10.brd, LEDLightSticks_V2--02--Power_Dist_PCB_v3.sch, LEDLightSticks_V2--03--Molex_Male_BMI_Breakout_PCB_v17.brd, LEDLightSticks_V2--03--Molex_Male_BMI_Breakout_PCB_v5.sch, LEDLightSticks_V2--04--USB_to_Molex_PCB_v15.sch, LEDLightSticks_V2--04--USB_to_Molex_PCB_v2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]
2021-01-05 restructured directory
    [V1--BASE--main.stl, V1--BASE.3mf, V1--BOTTOM--battery_securing_clip.stl, V1--BOTTOM--foundation_insert.stl, V1--BOTTOM--sheeth_cap.stl, V1--BOTTOM--sheeth_main--no_supports.stl, V1--BOTTOM--sheeth_main--supports.stl, V1--BOTTOM.3mf]
2021-01-06 One more pass of arduino code PRODUCTION READY!!! (and added Bottom Main STL)
    [V1p2--BOTTOM--sheeth_main.stl, V1p2--STEP2--BottomMain.3mf]
2021-01-07 Updated all 3D Models to use 4M mounting hardware
    [V1--BOTTOM--foundation_insert.stl, V1--TOP--foundation_insert.stl, V1p2--BOTTOM--battery_securing_clip.stl, V1p2--BOTTOM--power_shim_case_bottom.stl, V1p2--BOTTOM--power_shim_case_top.stl, V1p2--BOTTOM--power_shim_cover_bottom.stl, V1p2--BOTTOM--power_shim_cover_top.stl, V1p2--BOTTOM--sheeth_cap.stl]
2021-01-09 added M4 Enclosure STLs and 3MF files
    [V1p2--STEP2--BottomMain.3mf, V2p2--M4--STEP1--TopAndBottomInserts.3mf, V2p2_113--STEP3--Bottom-Cap_BattSec_PwrShimCase.3mf, V2p2_118--JIGS--M4.3mf, V2p2_118--STEP1--M4--TopAndBottomInserts.3mf, V2p2_118--STEP2--M4--BottomMain.3mf, V2p2_118--STEP2--M4--BottomMainFAST.3mf, V2p2_118--STEP4--M4--TopSheethCap.3mf]
2021-01-09 updated power shim casing to fit snuggly with Molex 1.5A USB plug
    [V2p2_113--STEP3--Bottom-Cap_BattSec_PwrShimCase.3mf, V2p2_113--STEP3p1--Bottom-Cap_BatteryClip.3mf, V2p2_113--STEP3p2--Bottom-PowerShimCasing.3mf]
2021-01-10 added pcb cover in base and Storage container for power Shim
    [V2p2_005--STORAGE--Base.3mf, V2p2_113--STEP3p2--Bottom-PowerShimCase_BatteryClip_DockPCBCover.3mf, V2p2_113--STEP3p2--Bottom-PowerShimCasing.3mf]
2021-01-16 Reorganized all 3D Model files and streamlined naming conventions
    [V1p2--JIGS.3mf, V1p2--STEP1--TopAndBottomInserts.3mf, V1p2--STEP2--BottomMain_Updated.3mf, V1p2--STEP2--BottomMain_Updated_FAST.3mf, V1p2--STEP3--Bottom-Cap_BattSec_PwrShimCase.3mf, V1p2--STEP4--TopSheethAndCap.3mf, V2p2_005--STORAGE--Base.3mf, V2p2_005--power_shim_storage.3mf]
2021-01-19 Updated all 3mf files and STLs to version 123
    [V1p2--JIGS.3mf, V1p2--STEP3--Bottom-Cap_BattSec_PwrShimCase.3mf, V1p2_113--10_32--Handle.3mf, V1p2_113--10_32--Handle_FAST.3mf, V1p2_118--10_32--TopCover.3mf, V1p2_123--10_32--Inserts.3mf, V2p2_113--M4--Cap.3mf, V2p2_113--M4--Small_Components.3mf]
2021-02-15 Updated a bunch of 3D Models
    [V2p2_057--Base.3mf, V2p2_123--10_32--Handle_FAST.3mf, V2p2_123--10_32--TopCover.3mf, V2p2_123--10_32--TopCover_2Piece_MAIN.3mf, V2p2_123--10_32--handle.3mf, V2p2_123--Bottom_Cap.3mf, V2p2_123--M4--Handle.3mf, V2p2_123--M4--Handle_FAST.3mf]
2021-02-16 finished updating all 3d models and 3MF files to latest
    [V2p2_005--power_shim_storage.3mf, V2p2_006--power_shim_storage.3mf, V2p2_058--Base.3mf, V2p2_123--Bottom_Cap.3mf, V2p2_123--M4--Handle_FAST.3mf, V2p2_123--M4--TopCover.3mf, V2p2_123--M4--TopCover_2Piece.3mf, V2p2_125--M4--TopCover_COMPLETE.3mf]
2021-02-16 removed 3D Model files for 10_32 hardware version
    [V1p2--JIGS.3mf, V1p2_113--10_32--Handle.3mf, V1p2_113--10_32--Handle_FAST.3mf, V1p2_118--10_32--TopCover.3mf, V1p2_123--10_32--Inserts.3mf, V2p2_123--10_32--Handle_FAST.3mf, V2p2_123--10_32--Inserts.3mf, V2p2_123--10_32--TopCover_2Piece_MAIN.3mf]
2021-02-16 added STL files
    [V2p2--Jig_123.stl, V2p2--M4--Insert_bottom_123.stl, V2p2--M4--Insert_top_123.stl, V2p2--M4--TopCover_COMPLETE_126.stl, V2p2--M4--handle_123.stl, V2p2--M4--handle_127.stl, V2p2--battery_clip_123.stl, V2p2--bottom_cap_125.stl]
2021-03-30 updated enclosure
    [V2p2_047--pcb_cover.3mf, V2p2_126--M4--TopCover_COMPLETE_FAST.3mf, V2p2_127--M4--AllMainComponents.3mf]
2021-03-30 added hasonoffswitch boolean to teensy
2024-03-03 updated hardware defs to include Trinket Pro and added latest 3D Print Files
    [STEP_BottomCoverCap_for_jake.step, STEP_BottomStructureMain_for_jake.step, V2p2--M4--Insert_bottom_133.stl, V2p2--M4--Insert_top_133.stl, V2p2--M4--Inserts--133.3mf, V2p2--M4--Inserts-123.3mf, V2p2--M4--TopCover_COMPLETE_133.stl, V2p2--M4--handle_133.stl]
2024-06-23 Update README.md added power shim case 3d models
